xmyoot/rpi-cm5-edge-carrier/docs/img/layer_In1.png

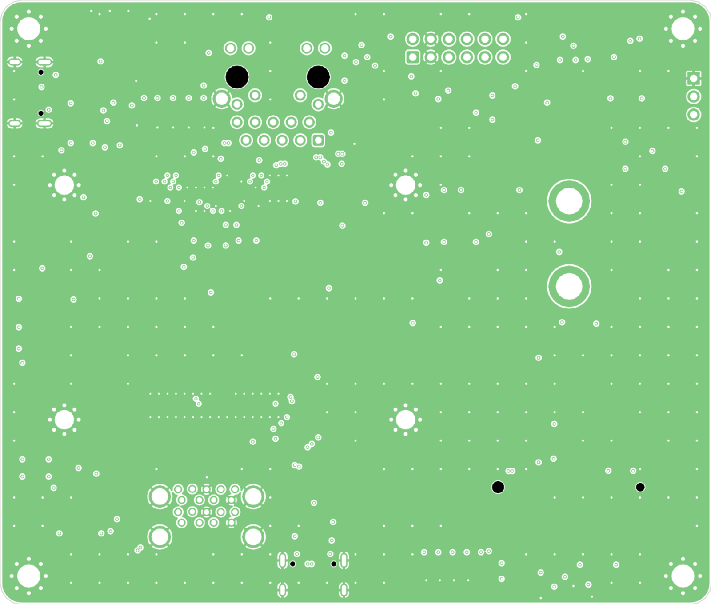
docs/img/layer_In1.png
