xmyoot/rpi-cm5-edge-carrier/docs/img/layer_In2.png

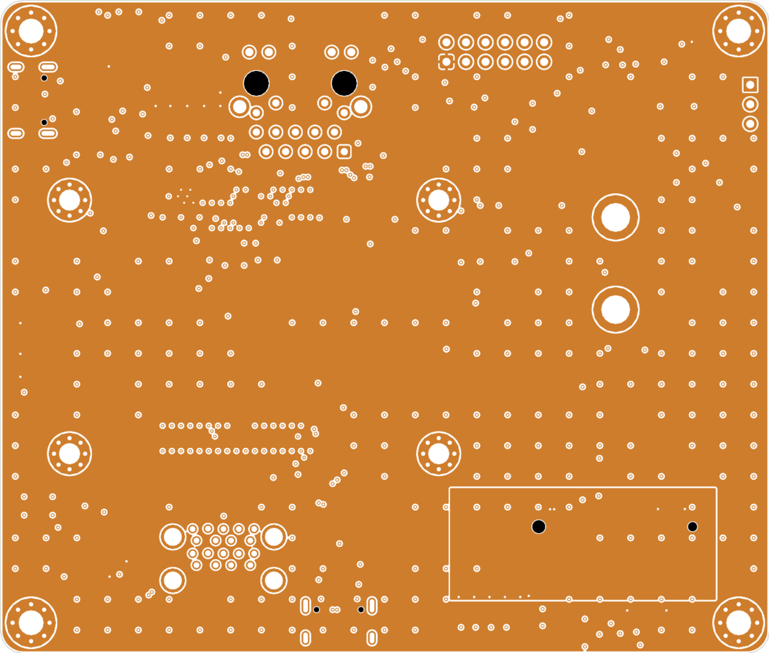
docs/img/layer_In2.png
