xmyoot/rpi-cm5-edge-carrier/docs/img/render_bottom.png

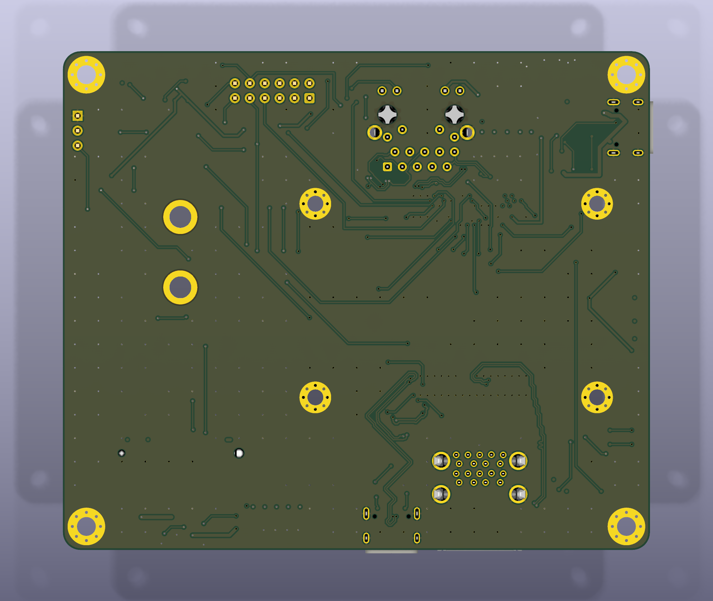
docs/img/render_bottom.png
