xmyoot/rpi-cm5-edge-carrier/docs/img/schematic-3.png

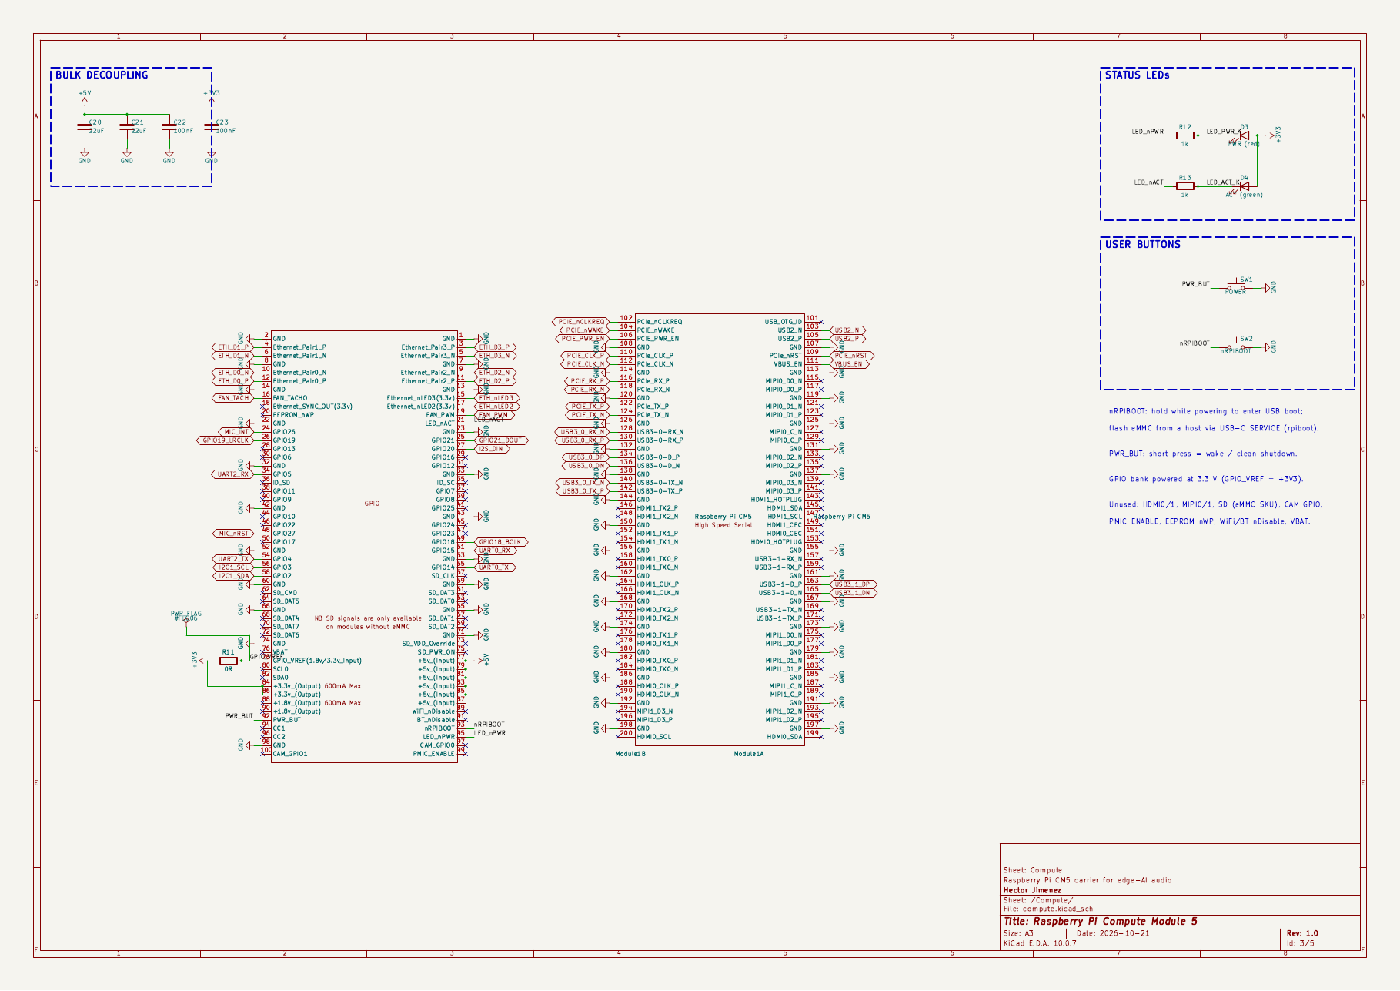
docs/img/schematic-3.png
