xmyoot/rpi-cm5-edge-carrier/docs/img/schematic-5.png

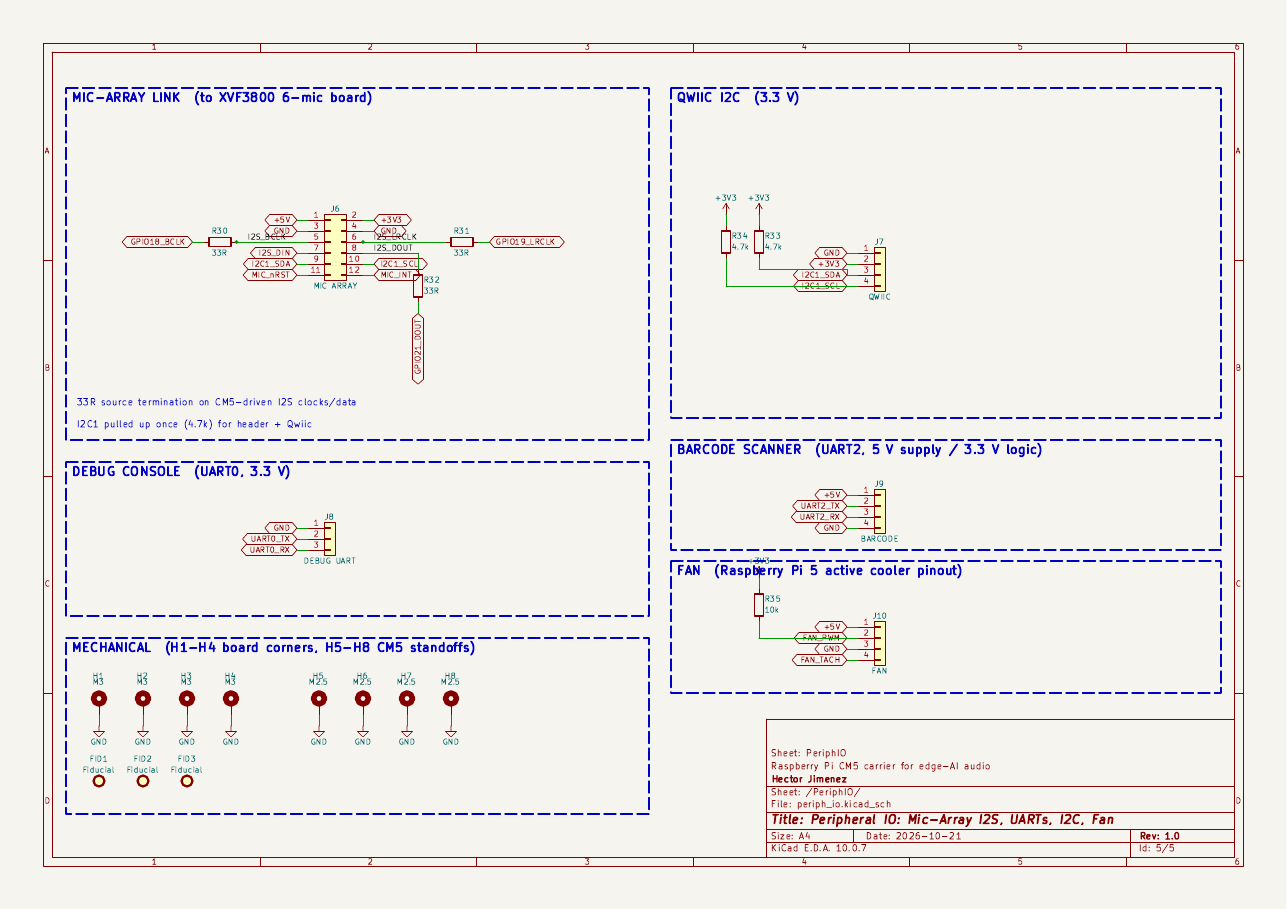
docs/img/schematic-5.png
