xmyoot/rpi-cm5-edge-carrier/fab/CM5_Edge_Carrier_BOM_JLC.csv

Comment | Designator | Footprint | Quantity | Manufacturer Part | JLCPCB Part #
22uF | C1,C2,C4 | C_1206_3216Metric | 3 |  | C12891
1uF | C3 | C_0402_1005Metric | 1 |  | C52923
100nF | C5,C6,C11,C17,C22,C23,C30,C34,C35 | C_0402_1005Metric | 9 |  | C1525
22uF | C7,C8,C9,C10,C20,C21,C32,C33 | C_0805_2012Metric | 8 |  | C45783
10uF | C12,C14,C15,C16,C31 | C_0805_2012Metric | 5 |  | C15850
4.7nF | C13 | C_0402_1005Metric | 1 |  | C1538
SMAJ15A | D1 | D_SMA | 1 | Littelfuse SMAJ15A
PD_OK | D2 | LED_0603_1608Metric | 1 |  | C72043
PWR (red) | D3 | LED_0603_1608Metric | 1 |  | C2286
ACT (green) | D4 | LED_0603_1608Metric | 1 |  | C72043
SSD (green) | D5 | LED_0603_1608Metric | 1 |  | C72043
USB-C PD IN | J1 | USB_C_Receptacle_GCT_USB4105-xx-A_16P_TopMnt_Horizontal | 1 | GCT USB4105-GF-A | C3020560
M.2 M-Key (NVMe 2230/2242) | J2 | M.2_M_Key_2242 | 1 | MTCONN MTSSD03-67MSW337 (H=3.2 mm)
USB 3.0 A x2 (stacked) | J3 | MTCONN_UBAF30-D2011 | 1 | MTCONN UBAF30-D2011
RJ45 MagJack 1000BASE-T | J4 | TRJG0926HENL | 1 | Trxcom TRJG0926HENL
USB-C SERVICE | J5 | USB_C_Receptacle_GCT_USB4105-xx-A_16P_TopMnt_Horizontal | 1 | GCT USB4105-GF-A | C3020560
MIC ARRAY | J6 | IDC-Header_2x06_P2.54mm_Vertical | 1 | 2x6 2.54 mm shrouded box header
QWIIC | J7 | JST_SH_SM04B-SRSS-TB_1x04-1MP_P1.00mm_Horizontal | 1 | JST SM04B-SRSS-TB | C160404
DEBUG UART | J8 | PinHeader_1x03_P2.54mm_Vertical | 1
BARCODE | J9 | JST_SH_SM04B-SRSS-TB_1x04-1MP_P1.00mm_Horizontal | 1 | JST SM04B-SRSS-TB | C160404
FAN | J10 | JST_SH_SM04B-SRSS-TB_1x04-1MP_P1.00mm_Horizontal | 1 | JST SM04B-SRSS-TB | C160404
2.2uH | L1 | L_Sunlord_MWSA0603S | 1 | Sunlord MWSA0603S-2R2MT
2.2uH | L2 | L_Bourns_SRP5030T | 1 | Bourns SRP5030T-2R2M
Raspberry Pi CM5 | Module1 | RPi_CM5_DF40 | 1 | Raspberry Pi CM5 + 2x Hirose DF40C-100DS-0.4V(51) | C597931 (x2)
1k | R1,R12,R13,R20 | R_0402_1005Metric | 4 |  | C11702
24k | R2 | R_0402_1005Metric | 1
4.7k | R3,R33,R34 | R_0402_1005Metric | 3 |  | C25900
100k | R4,R8 | R_0402_1005Metric | 2 |  | C25741
15k | R5,R21 | R_0402_1005Metric | 2 |  | C25756
56k | R6 | R_0402_1005Metric | 1 |  | C25796
10k | R7,R9,R35 | R_0402_1005Metric | 3 |  | C25744
2.2k | R10 | R_0402_1005Metric | 1 |  | C25879
0R | R11 | R_0402_1005Metric | 1 |  | C17168
470R | R22,R23 | R_0402_1005Metric | 2 |  | C25117
5.1k | R24,R25 | R_0402_1005Metric | 2 |  | C25905
33R | R30,R31,R32 | R_0402_1005Metric | 3 |  | C25105
POWER | SW1 | SW_SPST_B3U-1000P | 1 | Omron B3U-1000P | C231329
nRPIBOOT | SW2 | SW_SPST_B3U-1000P | 1 | Omron B3U-1000P | C231329
CH224K | U1 | SSOP-10-1EP_3.9x4.9mm_P1mm_EP2.1x3.3mm | 1 | WCH CH224K | C970725
TPS565208 | U2 | SOT-23-6 | 1 | TI TPS565208DDCR
AP3441SHE-7B | U3 | DFN-8-1EP_2x2mm_P0.5mm_EP0.9x1.7mm | 1 | Diodes AP3441SHE-7B
AP22653W6 | U4 | SOT-23-6 | 1 | Diodes AP22653W6-7
TPD4EUSB30 | U8,U9 | USON-10_2.5x1.0mm_P0.5mm | 2 | TI TPD4EUSB30DQAR
USBLC6-2SC6 | U10 | SOT-23-6 | 1 | ST USBLC6-2SC6 | C7519
