xmyoot/rpi-cm5-edge-carrier/fab/CM5_Edge_Carrier.step

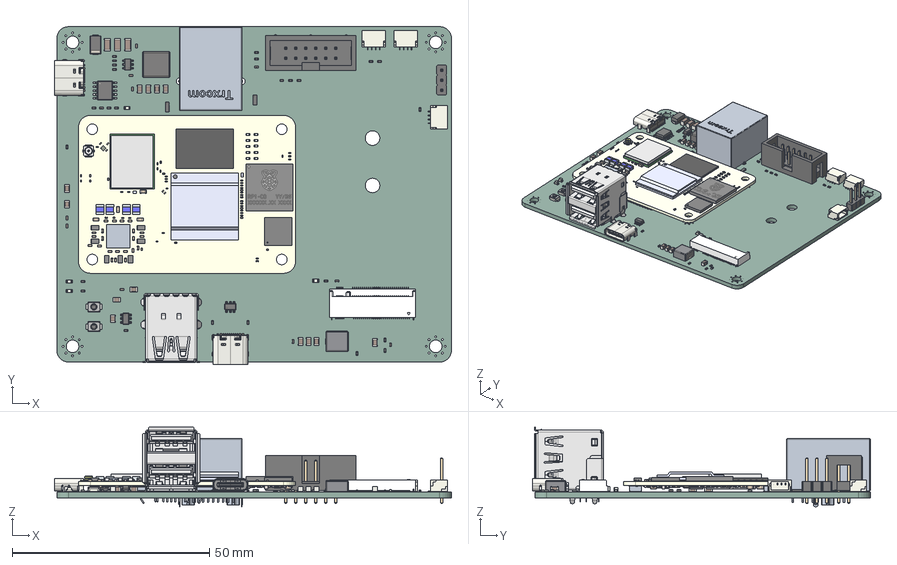
[picture p14: CAD file, 2026-10-21]
fab/CM5_Edge_Carrier.step
100.6 x 85.6 x 20.2 mm
PinHeader_1x03_P254mm_Vertical
R_0402_1005Metric x 25
LED_0603_1608Metric x 4
C_0402_1005Metric x 11
C_0805_2012Metric x 13
SW_SPST_B3U-1000P x 2
IDC_Header_2x06_P254mm_Vertical
SOT-23-6 x 3
SSOP-10-1EP_3.9x4.9mm_P1mm_EP2.1x3.3mm
MTSSD03-67MSW337(3D)
USON_10_25x10mm_Pitch05mm x 2
D_SMA
JST_SH_SM04B-SRSS-TB_1x04-1MP_P1.00mm_Horizontal x 3
TRJG0926HENL-S
USB_C_Receptacle_16P_TopMnt_Horizontal_GCT_USB4105-xx-A x 2
C_1206_3216Metric x 3
L_Bourns_SRP5030T
10164227-1001A1RLF x 2
200-ball_VFBGAold.step
CAP0201.step x 190
RES0201old.step x 71
CAP0402.step x 81
PMIC STEP.STEP
3D-SRP201208-R47MH-20230512 .step x 7
term2 x 4
term1 x 4
2712 v2 STEP.STEP
CAP0603.step x 10
RES0402.step x 10
SOT883B Mold body x 4
SOT883B4 LF x 4
User Library-SKY13351-378LF.step
ProjectY v3 STEP.STEP
(Unsaved)
PinIndicator
Pads x 2
Lid x 2
Plating
LDF
CPD
Pins
User Library-153BallWFBGA
10164228-1001A1RLF.stp x 2
ABM11-0022-T3.step x 2
DIELECTRIC_Model_1_Inst
USB30-DOUBLE-SHELL.stp.STEP
USB30-DOUBLE-HOUSING.stp.STEP
LONG-FEMALE-TERMINAL.stp.STEP
LONG-FEMALE-TERMINAL-1.stp.STEP
LONG-FEMALE-TERMINAL-2-3.stp.STEP x 2
SHORT-MALE-TERMINAL.stp.STEP x 5
SHORT-FEMALE-TERMINAL.stp.STEP x 2
USB30-MILDDLE-SHELL.stp.STEP
USB30-HOUSING-COVER.stp.STEP
5PLONG-2.stp.STEP x 4
LONG-MALE-TERMINAL.stp.STEP
SHORT-FEMALE-TERMINAL-2-3.stp.STEP x 2
a71ba5e0-8551-11ed-a139-00155d22e2d7_part
a71ba716-8551-11ed-a139-00155d22e2d7_part
a71ba78e-8551-11ed-a139-00155d22e2d7_part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
