xmyoot/rpi-cm5-edge-carrier/docs/CM5_Edge_Carrier_schematic.pdf

1 | 2 | 3 | 4 | 5 | 6 | 7 | 8

AB

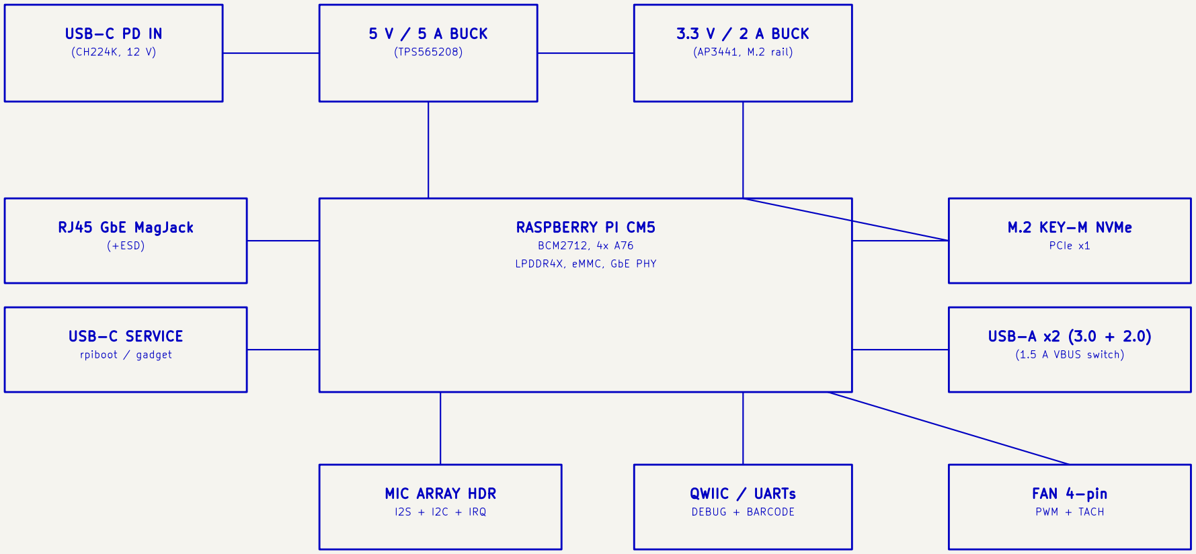
[picture p15: figure]
USB-C SERVICE; QWIIC / UARTs; DEBUG + BARCODE; FAN 4-pin; (1.5 A VBUS switch); USB-A x2 (3.0 + 2.0); USB-C PD IN; 5 V / 5 A BUCK; PCIe x1; (TPS565208); RASPBERRY PI CM5; LPDDR4X, eMMC, GbE PHY; M.2 KEY-M NVMe; RJ45 GbE MagJack; (+ESD); BCM2712, 4x A76; (AP3441, M.2 rail); MIC ARRAY HDR; I2S + I2C + IRQ; 3.3 V / 2 A BUCK; rpiboot / gadget; PWM + TACH

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
Size: A3 | Rev: 1.0 | F Date: 2026-10-21
KiCad E.D.A. 10.0.7 | Id: 1/5

## Title: CM5 Edge-Audio Carrier

File: CM5_Edge_Carrier.kicad_sch

Sheet: /

Hector Jimenez

Raspberry Pi CM5 carrier for edge-AI audio

Sheet: Root

PeriphIO

File: periph_io.kicad_sch

HighSpeed

File: highspeed.kicad_sch

Compute

File: compute.kicad_sch

Power File: power.kicad_sch

7. Boot: hold nRPIBOOT while plugging USB-C SERVICE into a host to flash eMMC with rpiboot.
6. Stackup: JLCPCB JLC04161H-7628, 1.6 mm, L1 SIG / L2 GND / L3 PWR (+5V, +3V3_M2) / L4 SIG.
5. ESD: TPD4EUSB30 on every GbE pair, USBLC6-2 on service USB-C, SMAJ15A on VBUS (USB-A per RPi reference).

## Hierarchical sheets

Power: USB-C PD Input, 5 V and 3.3 V Bucks

Raspberry Pi Compute Module 5

3. PCIe x1 (Gen2 default, Gen3 via dtparam=pciex1_gen=3): 85 ohm diff, length-matched P/N within 0.1 mm. | High-Speed IO: PCIe NVMe, USB 3.0, GbE, USB-C Service

Peripheral IO: Mic-Array I2S, UARTs, I2C, Fan

1. Input: USB-C PD sink requests 12 V / 3 A (36 W). Buck EN divider (100k/15k) holds the 5 V rail off below ~9 V,

# CM5 Edge-Audio Carrier - System Block Diagram

4. USB 3.0 SuperSpeed: 90 ohm diff; GbE MDI: 100 ohm diff; all on L1 referenced to solid GND on L2.

TX AC-coupling capacitors are on the CM5; RX caps are on the NVMe module.

2. CM5 CC1/CC2 left open: set usb_max_current_enable=1 in config.txt to allow 1.6 A on the USB-A ports.

so a non-PD 5 V source can never back-feed the CM5 at low voltage.

## DESIGN NOTES

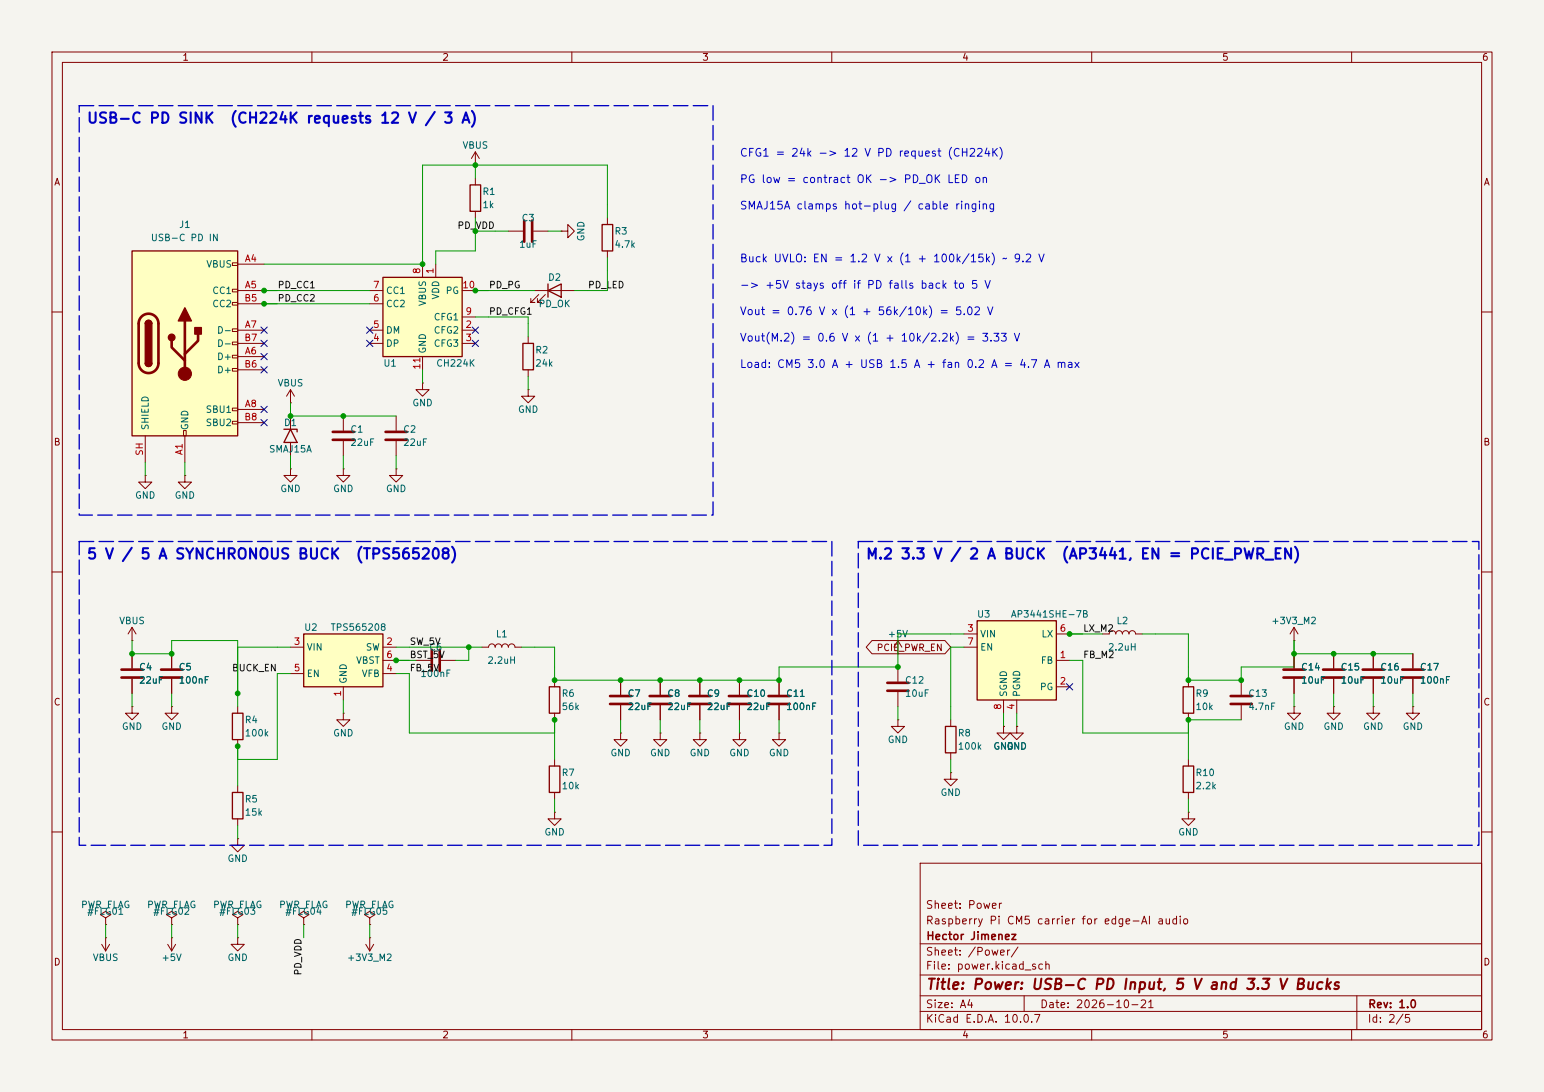
[picture p16: page 2]

USB-C PD SINK (CH224K requests 12 V / 3 A)

PG low = contract OK -> PD_OK LED on 5 V / 5 A SYNCHRONOUS BUCK (TPS565208)

SMAJ15A clamps hot-plug / cable ringing

Vout = 0.76 V x (1 + 56k/10k) = 5.02 V -> +5V stays off if PD falls back to 5 V

Vout(M.2) = 0.6 V x (1 + 10k/2.2k) = 3.33 V
Load: CM5 3.0 A + USB 1.5 A + fan 0.2 A = 4.7 A max M.2 3.3 V / 2 A BUCK (AP3441, EN = PCIE_PWR_EN)

Raspberry Pi CM5 carrier for edge-AI audio
Hector Jimenez
Sheet: /Power/
File: power.kicad_sch
Title: Power: USB-C PD Input, 5 V and 3.3 V Bucks

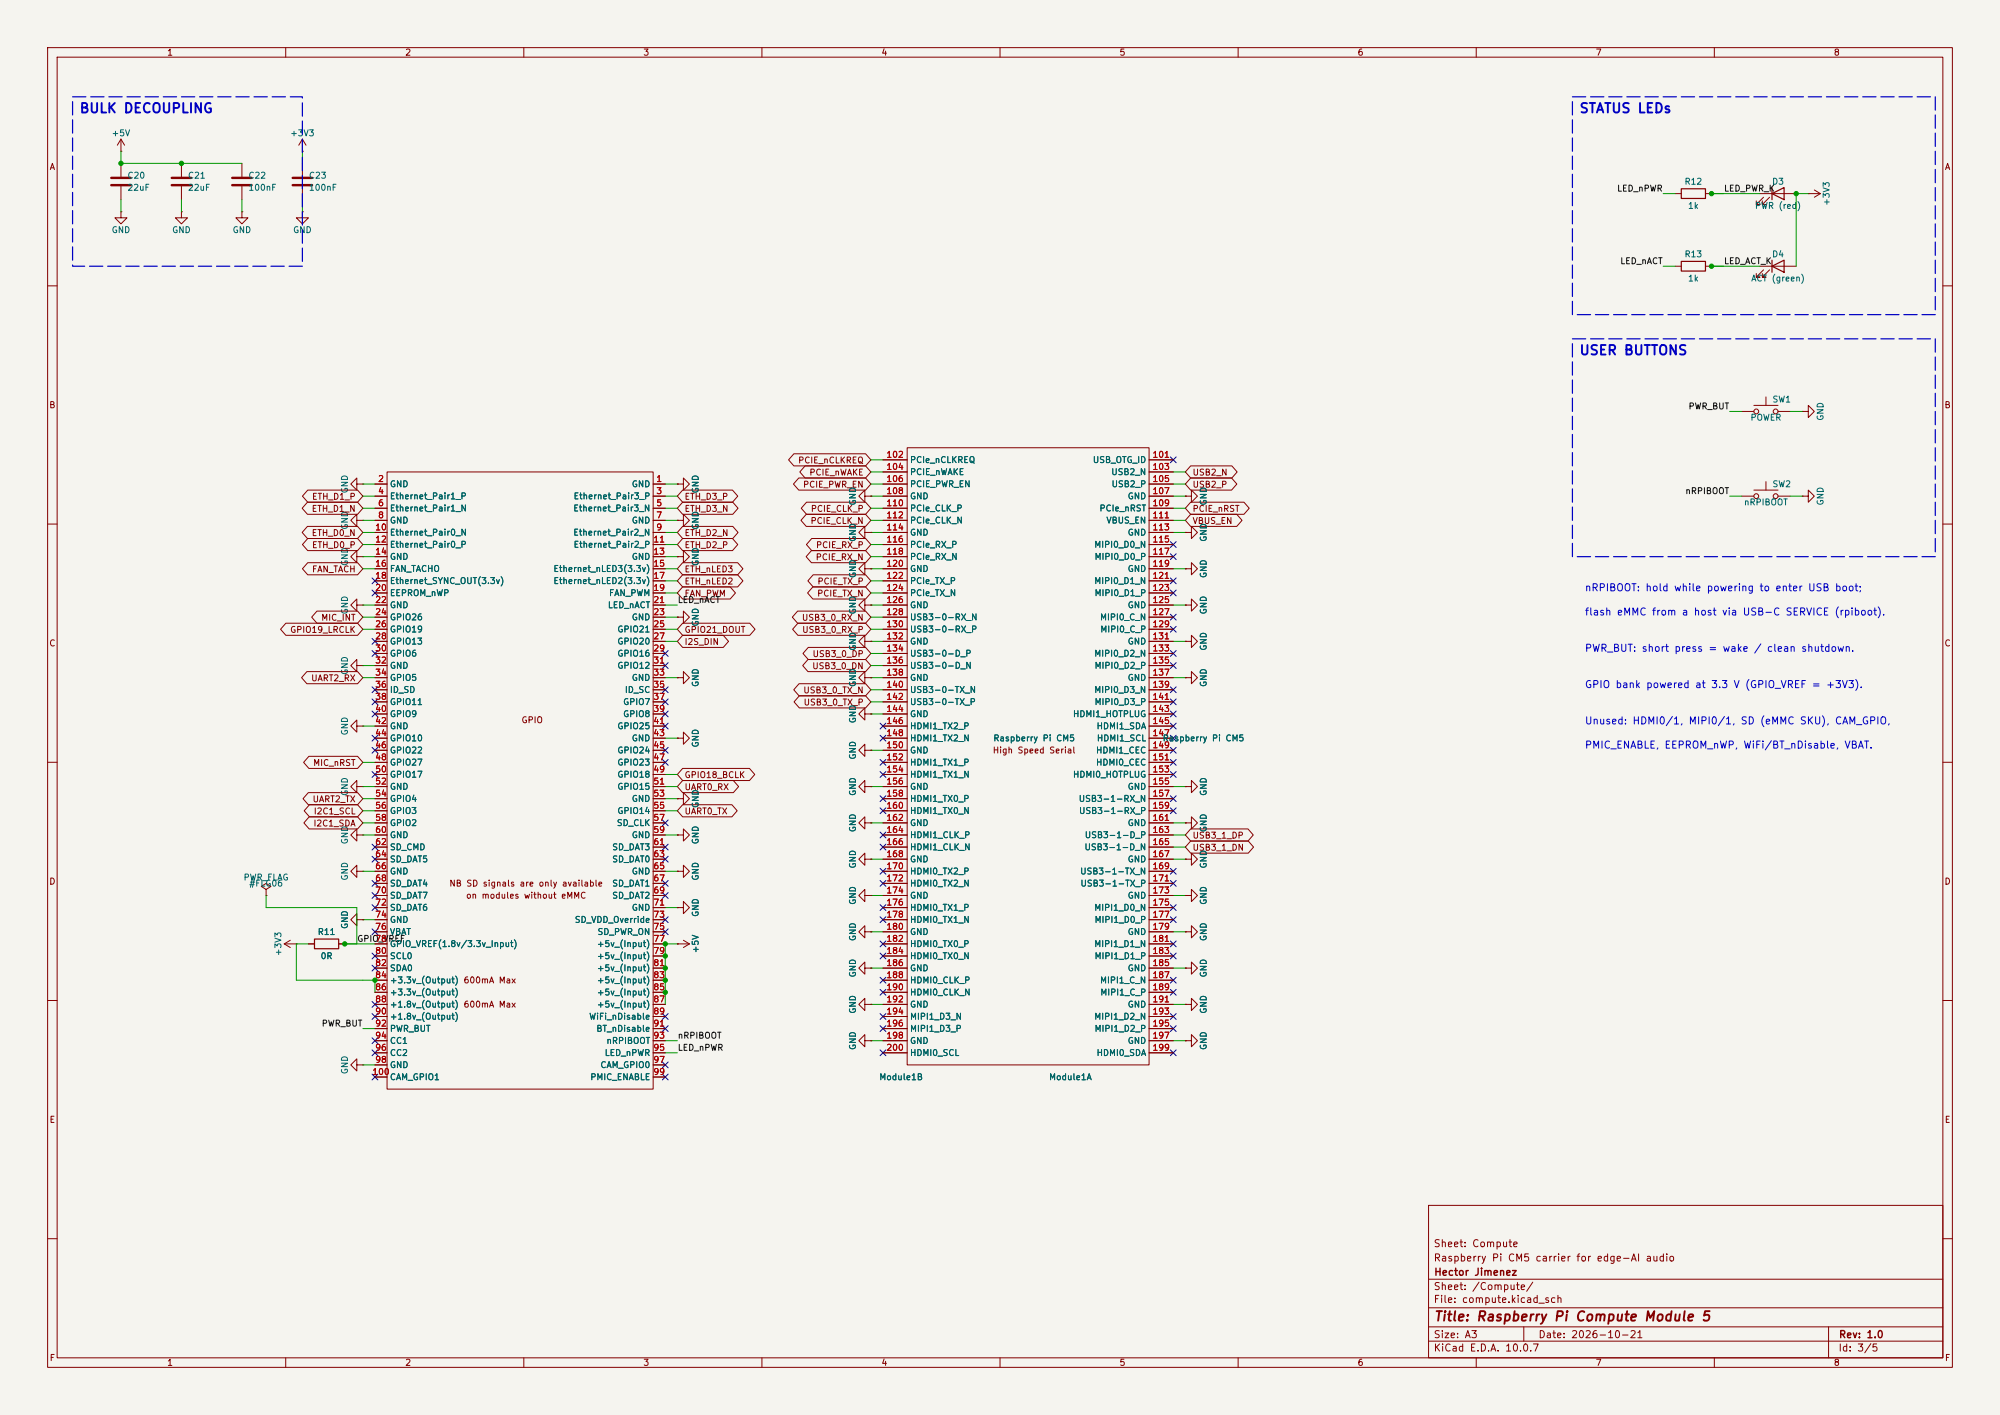
[picture p17: page 3]

nRPIBOOT: hold while powering to enter USB boot;

Sheet: Compute GND GND GND

flash eMMC from a host via USB-C SERVICE (rpiboot).

PWR_BUT: short press = wake / clean shutdown.

GPIO bank powered at 3.3 V (GPIO_VREF = +3V3).

Unused: HDMI0/1, MIPI0/1, SD (eMMC SKU), CAM_GPIO,

600mA Max 600mA Max NB SD signals are only available on modules without eMMC

Raspberry Pi CM5 carrier for edge-AI audio
Hector Jimenez
Sheet: /Compute/
File: compute.kicad_sch
Title: Raspberry Pi Compute Module 5

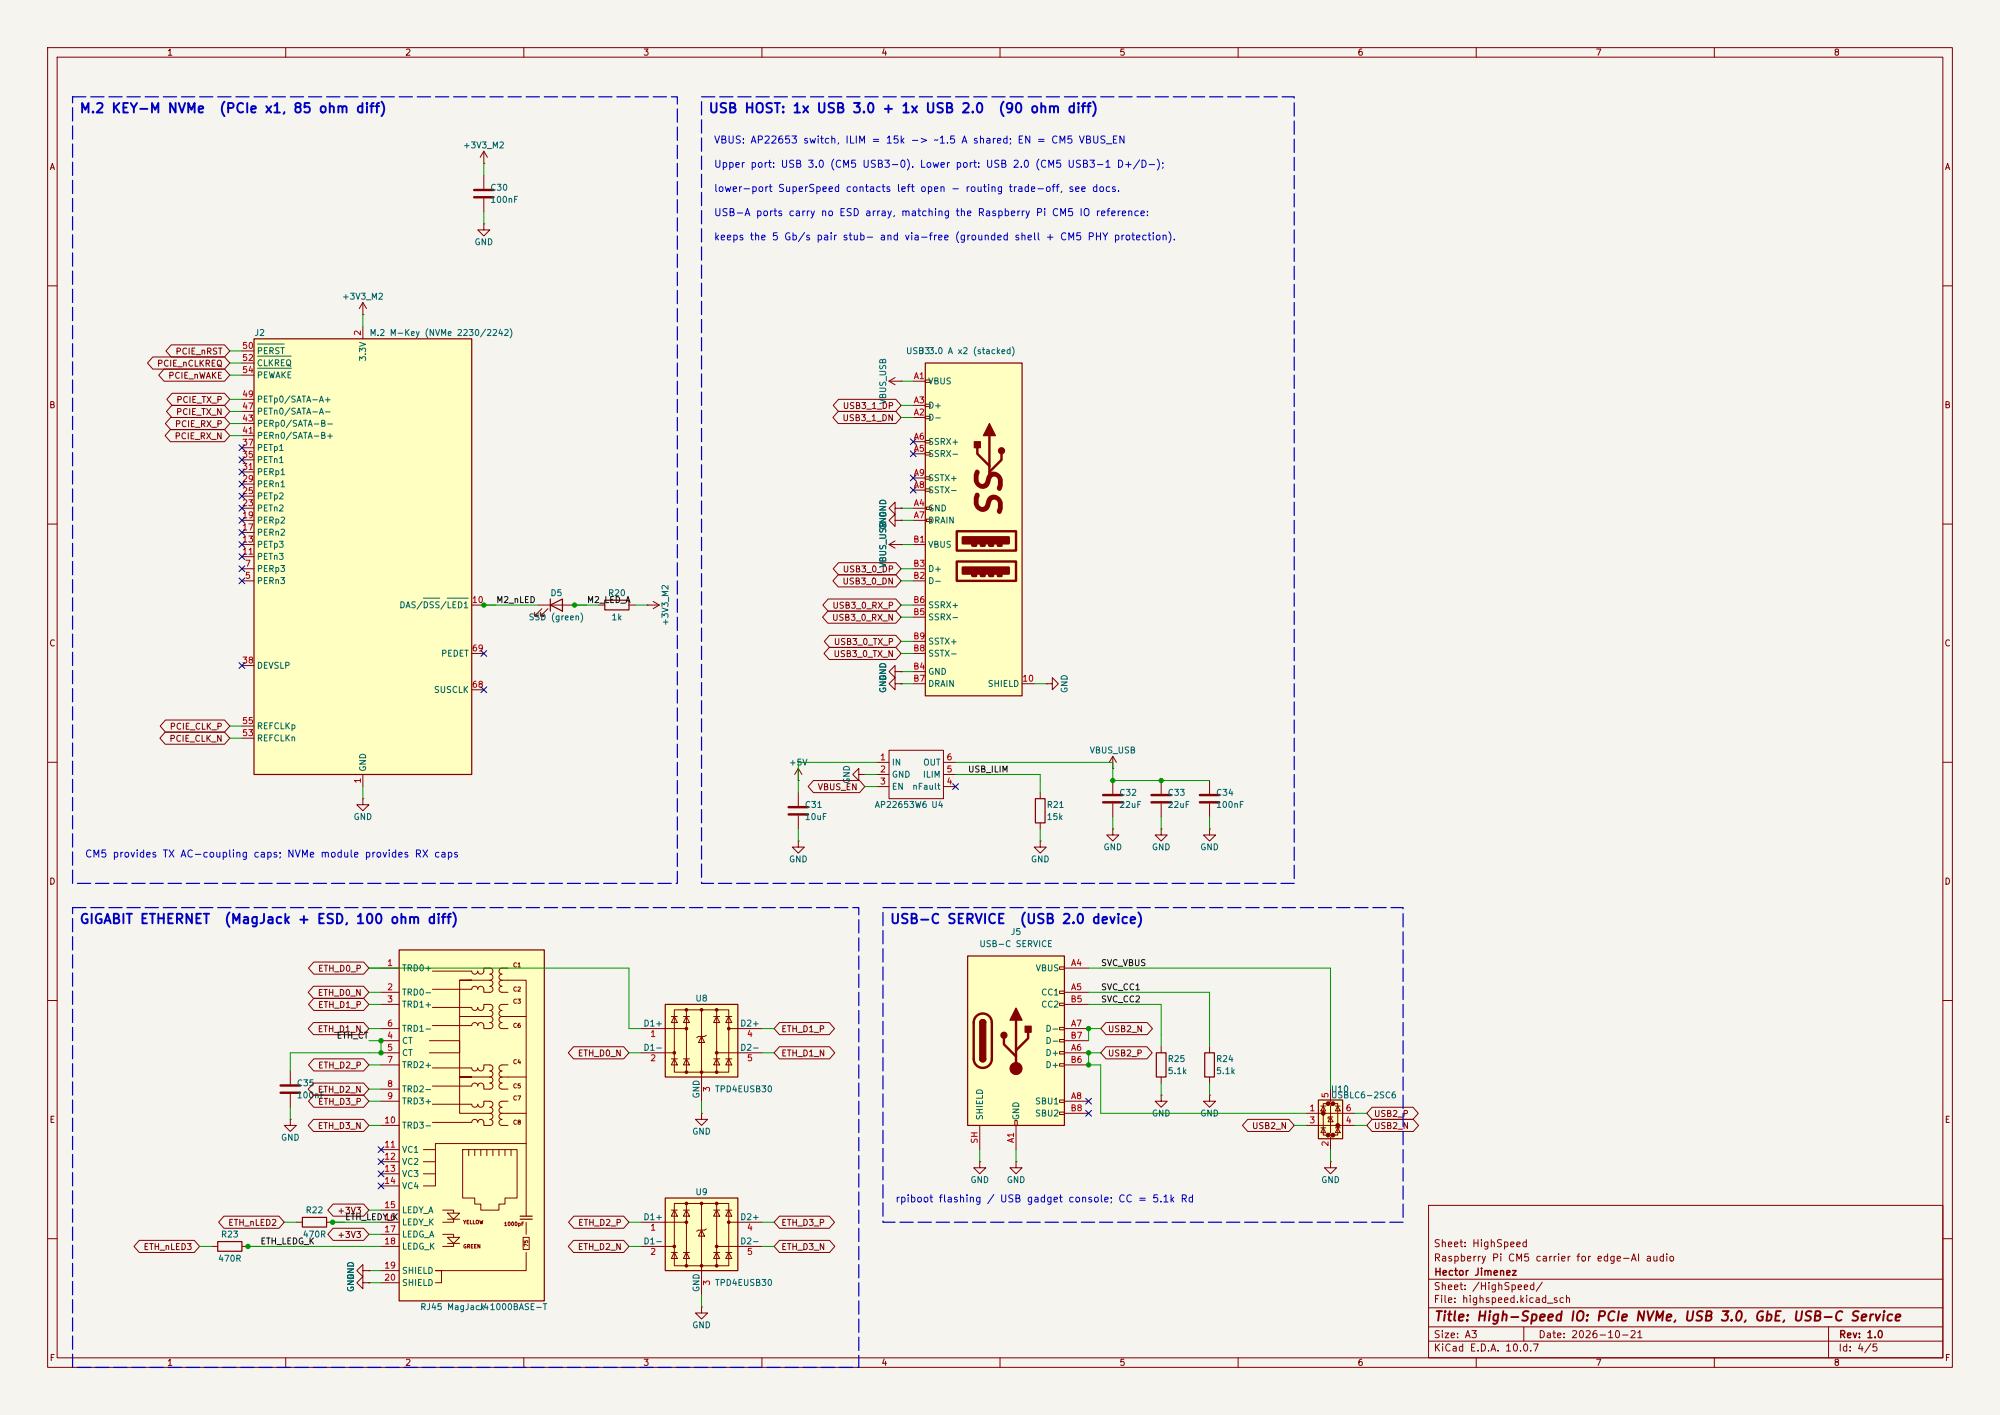
[picture p18: page 4]

M.2 KEY-M NVMe (PCIe x1, 85 ohm diff)

USB HOST: 1x USB 3.0 + 1x USB 2.0 (90 ohm diff)

VBUS: AP22653 switch, ILIM = 15k -> ~1.5 A shared; EN = CM5 VBUS_EN

Upper port: USB 3.0 (CM5 USB3-0). Lower port: USB 2.0 (CM5 USB3-1 D+/D-);

lower-port SuperSpeed contacts left open - routing trade-off, see docs.

keeps the 5 Gb/s pair stub- and via-free (grounded shell + CM5 PHY protection).

1 3.3V 2 PERn3 5 PERp3 7 DAS/DSS/LED1 10 PETn3 11 PETp3 13 PERn2 17 PERp2 19 PETn2 23 PETp2 25 PERn1 29 PERp1 31 PETn1 35 PETp1 37 DEVSLP 38 PERn0/SATA-B+ 41 PERp0/SATA-B- 43 PETn0/SATA-A- 47 PETp0/SATA-A+ 49 PERST 50 CLKREQ 52 REFCLKn 53 PEWAKE 54 REFCLKp 55

USB-C SERVICE (USB 2.0 device) GND VBUS_USB GND GND

CM5 provides TX AC-coupling caps; NVMe module provides RX caps

GIGABIT ETHERNET (MagJack + ESD, 100 ohm diff)

rpiboot flashing / USB gadget console; CC = 5.1k Rd

Sheet: HighSpeed
Raspberry Pi CM5 carrier for edge-AI audio
Hector Jimenez
Sheet: /HighSpeed/
File: highspeed.kicad_sch
Title: High-Speed IO: PCIe NVMe, USB 3.0, GbE, USB-C Service

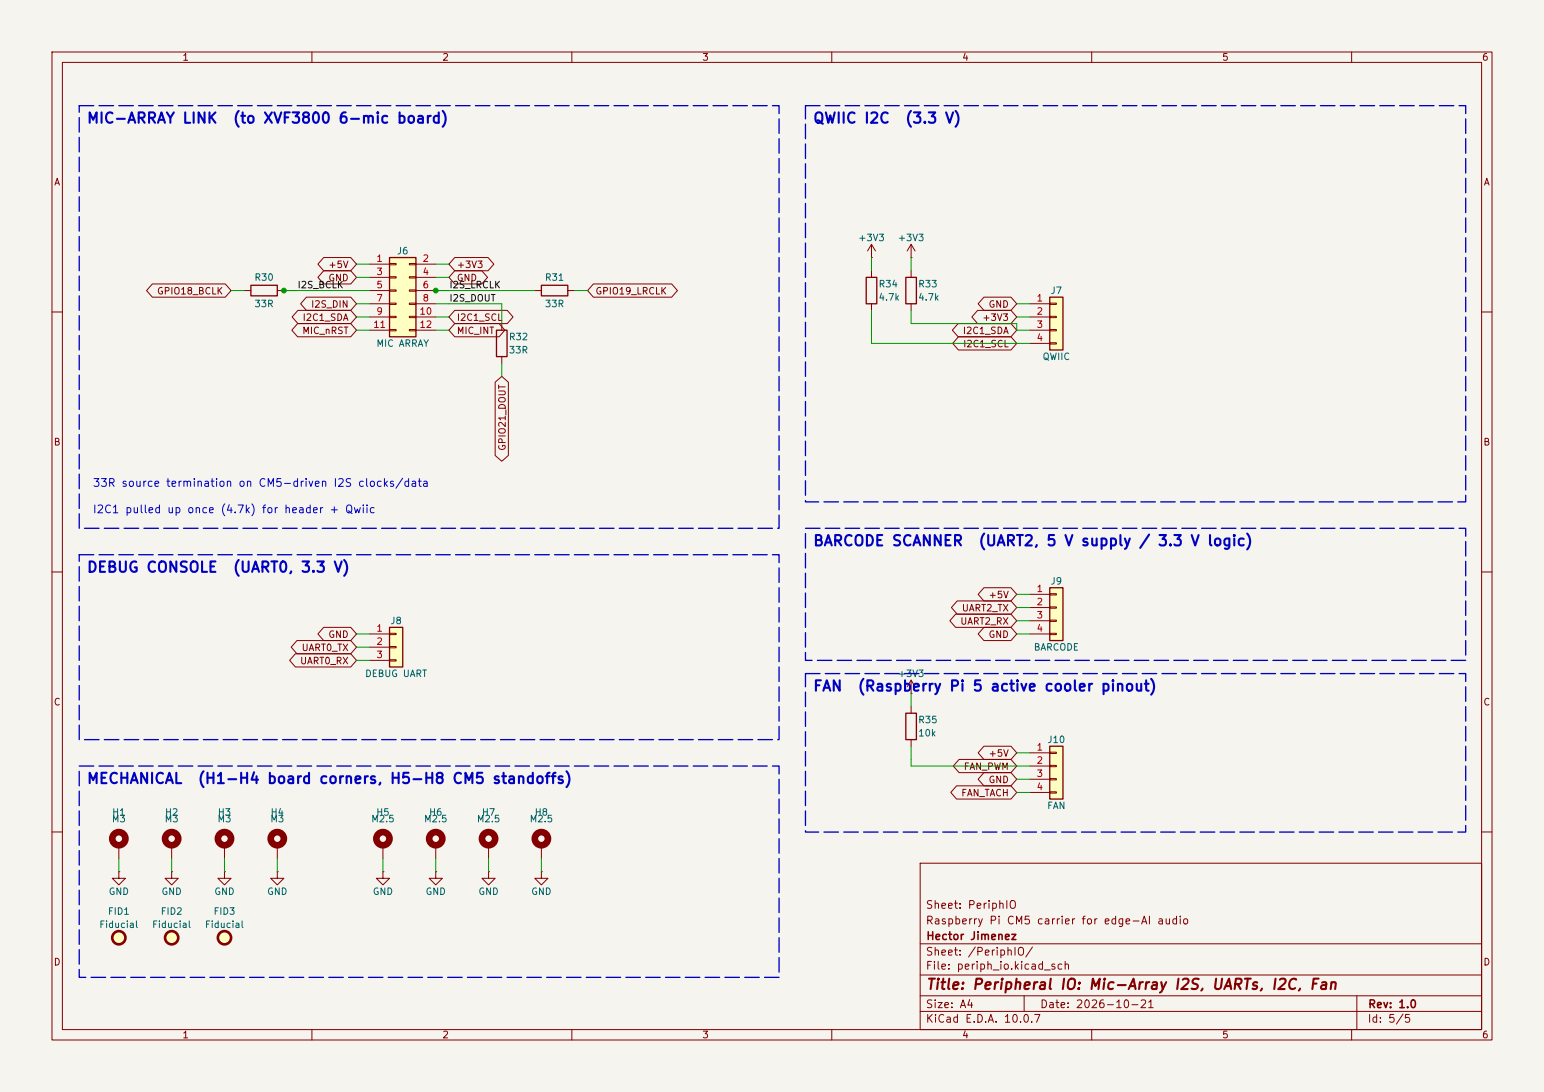
[picture p19: page 5]

MIC-ARRAY LINK (to XVF3800 6-mic board)

33R source termination on CM5-driven I2S clocks/data

I2C1 pulled up once (4.7k) for header + Qwiic

BARCODE SCANNER (UART2, 5 V supply / 3.3 V logic)

MECHANICAL (H1-H4 board corners, H5-H8 CM5 standoffs)

Sheet: PeriphIO
Raspberry Pi CM5 carrier for edge-AI audio
Hector Jimenez
Sheet: /PeriphIO/
File: periph_io.kicad_sch
Title: Peripheral IO: Mic-Array I2S, UARTs, I2C, Fan
