xmyoot/rpi-cm5-edge-carrier/fab/CM5_Edge_Carrier_top_assembly.pdf

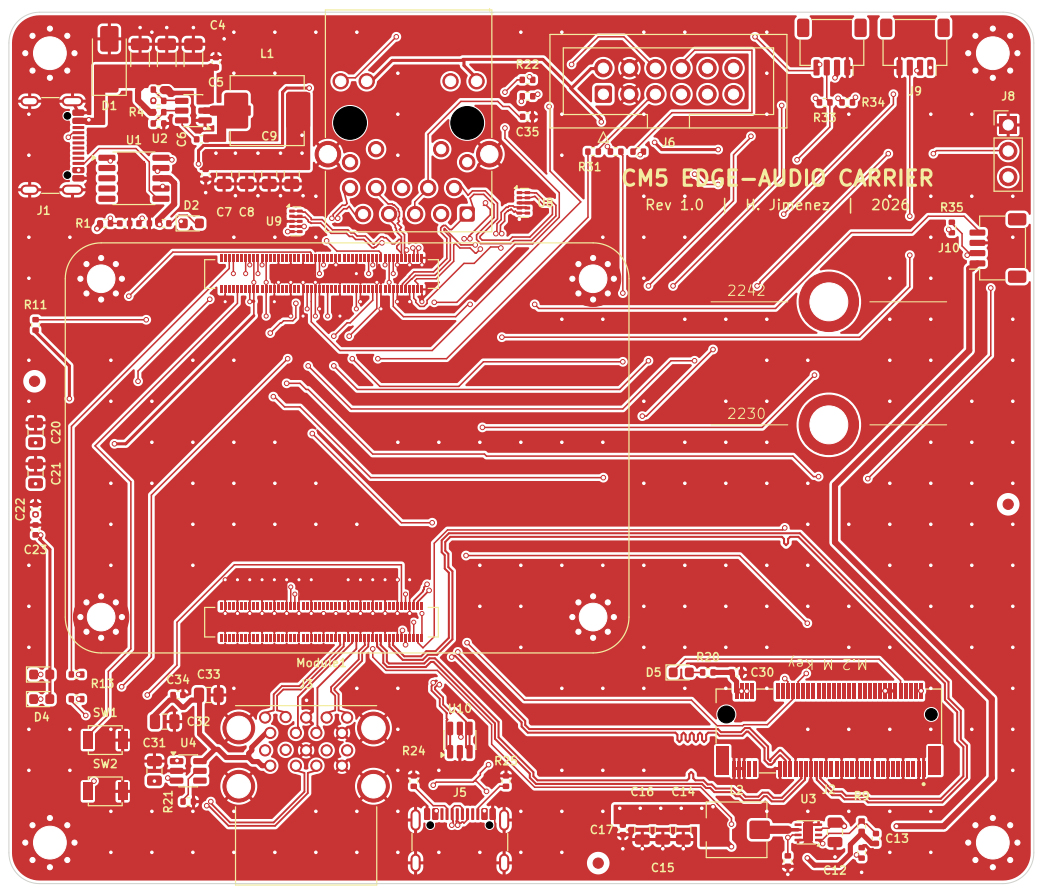
[picture p20: page 1]

Rev 1.0 | H. Jimenez | 2026 CM5 EDGE-AUDIO CARRIER
