xmyoot/rpi-cm5-edge-carrier/hardware/CM5_Edge_Carrier.kicad_pcb

## KiCad design hardware/CM5_Edge_Carrier.kicad_pcb (2026-10-21)

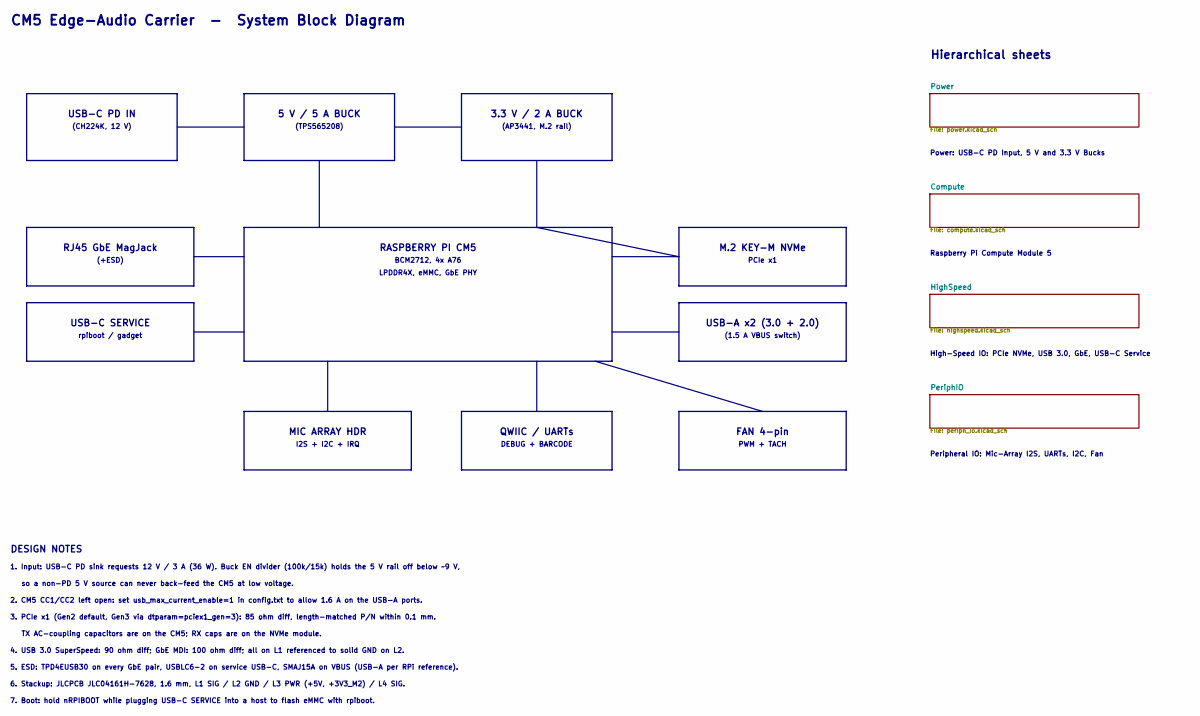
[picture p21: schematic CM5_Edge_Carrier.kicad_sch, CM5 Edge-Audio Carrier]

Notes on the sheet:
USB-C PD IN
(CH224K, 12 V)
5 V / 5 A BUCK
(TPS565208)
3.3 V / 2 A BUCK
(AP3441, M.2 rail)
RASPBERRY PI CM5
BCM2712, 4x A76
LPDDR4X, eMMC, GbE PHY
M.2 KEY-M NVMe
PCIe x1
USB-A x2 (3.0 + 2.0)
(1.5 A VBUS switch)
RJ45 GbE MagJack
(+ESD)
USB-C SERVICE
rpiboot / gadget
MIC ARRAY HDR
I2S + I2C + IRQ
QWIIC / UARTs
DEBUG + BARCODE
FAN 4-pin
PWM + TACH
CM5 Edge-Audio Carrier - System Block Diagram
DESIGN NOTES
1. Input: USB-C PD sink requests 12 V / 3 A (36 W). Buck EN divider (100k/15k) holds the 5 V rail off below ~9 V,
so a non-PD 5 V source can never back-feed the CM5 at low voltage.
2. CM5 CC1/CC2 left open: set usb_max_current_enable=1 in config.txt to allow 1.6 A on the USB-A ports.
3. PCIe x1 (Gen2 default, Gen3 via dtparam=pciex1_gen=3): 85 ohm diff, length-matched P/N within 0.1 mm.
TX AC-coupling capacitors are on the CM5; RX caps are on the NVMe module.
4. USB 3.0 SuperSpeed: 90 ohm diff; GbE MDI: 100 ohm diff; all on L1 referenced to solid GND on L2.
5. ESD: TPD4EUSB30 on every GbE pair, USBLC6-2 on service USB-C, SMAJ15A on VBUS (USB-A per RPi reference).
6. Stackup: JLCPCB JLC04161H-7628, 1.6 mm, L1 SIG / L2 GND / L3 PWR (+5V, +3V3_M2) / L4 SIG.
7. Boot: hold nRPIBOOT while plugging USB-C SERVICE into a host to flash eMMC with rpiboot.
Hierarchical sheets
Power: USB-C PD Input, 5 V and 3.3 V Bucks
Raspberry Pi Compute Module 5
High-Speed IO: PCIe NVMe, USB 3.0, GbE, USB-C Service
Peripheral IO: Mic-Array I2S, UARTs, I2C, Fan

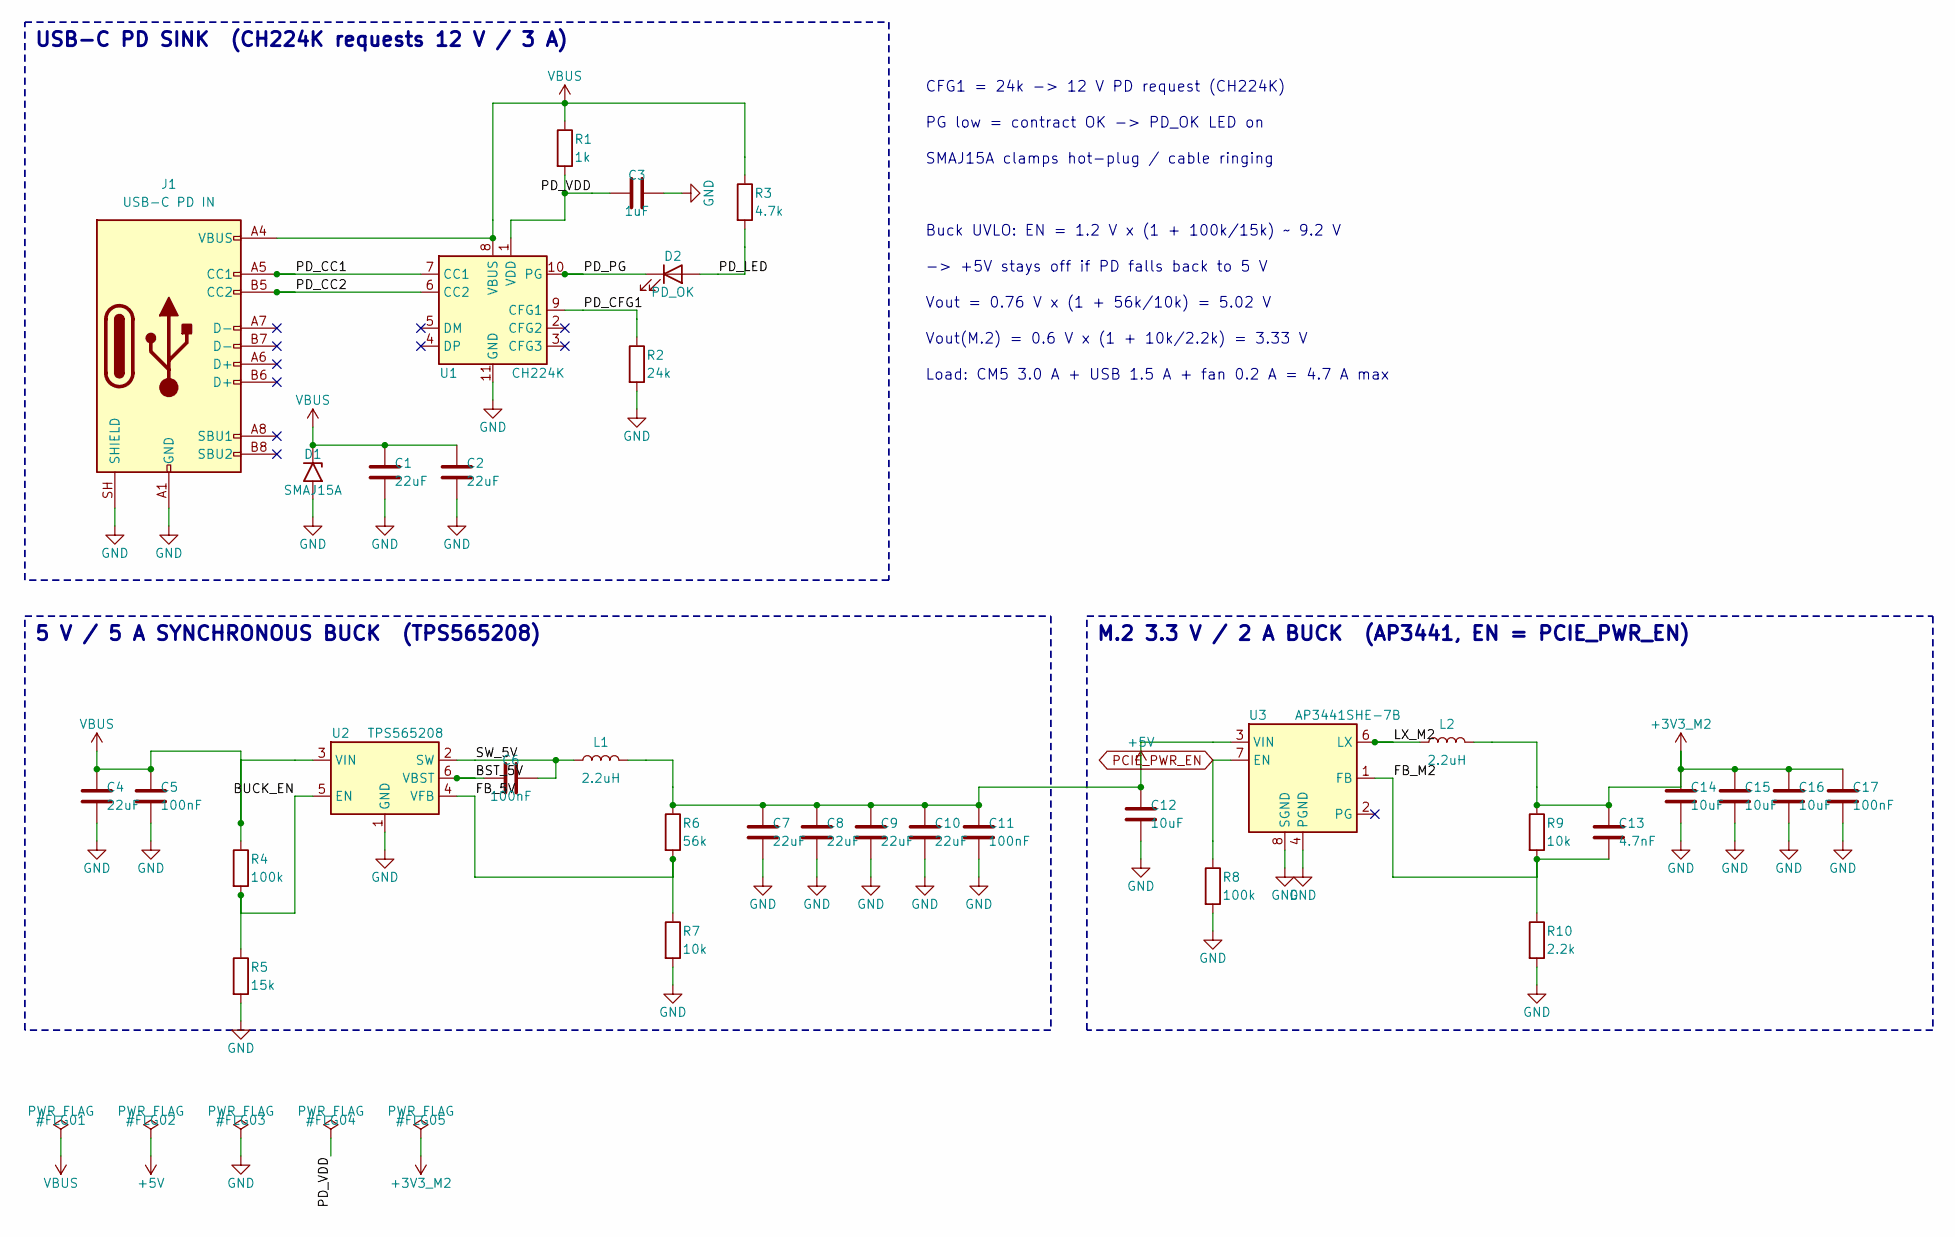
[picture p22: schematic power.kicad_sch, Power: USB-C PD Input, 5 V and 3.3 V Bucks]

Parts:
C1, C2, C4: 22uF; C_1206_3216Metric; Voltage 25V; LCSC C12891
C3: 1uF; C_0402_1005Metric; Voltage 16V; LCSC C52923
C5, C6, C11, C17: 100nF; C_0402_1005Metric; Voltage 16V; LCSC C1525
C7, C8, C9, C10: 22uF; C_0805_2012Metric; Voltage 10V; LCSC C45783
C12, C14, C15, C16: 10uF; C_0805_2012Metric; Voltage 10V; LCSC C15850
C13: 4.7nF; C_0402_1005Metric; Voltage 16V; LCSC C1538
D1: SMAJ15A; D_SMA; MPN Littelfuse SMAJ15A
D2: PD_OK; LED_0603_1608Metric; LCSC C72043
J1: USB-C PD IN; USB_C_Receptacle_GCT_USB4105-xx-A_16P_TopMnt_Horizontal; MPN GCT USB4105-GF-A; LCSC C3020560
L1: 2.2uH; L_Sunlord_MWSA0603S; Rating 2.2uH 10A; MPN Sunlord MWSA0603S-2R2MT
L2: 2.2uH; L_Bourns_SRP5030T; Rating 2.2uH 6.5A; MPN Bourns SRP5030T-2R2M
R1: 1k; R_0402_1005Metric; Tolerance 1%; LCSC C11702
R2: 24k; R_0402_1005Metric; Tolerance 1%
R3: 4.7k; R_0402_1005Metric; Tolerance 1%; LCSC C25900
R4, R8: 100k; R_0402_1005Metric; Tolerance 1%; LCSC C25741
R5: 15k; R_0402_1005Metric; Tolerance 1%; LCSC C25756
R6: 56k; R_0402_1005Metric; Tolerance 1%; LCSC C25796
R7, R9: 10k; R_0402_1005Metric; Tolerance 1%; LCSC C25744
R10: 2.2k; R_0402_1005Metric; Tolerance 1%; LCSC C25879
U1: CH224K; SSOP-10-1EP_3.9x4.9mm_P1mm_EP2.1x3.3mm; MPN WCH CH224K; LCSC C970725
U2: TPS565208; SOT-23-6; MPN TI TPS565208DDCR
U3: AP3441SHE-7B; DFN-8-1EP_2x2mm_P0.5mm_EP0.9x1.7mm; MPN Diodes AP3441SHE-7B

Connections:
+3V3_M2: C13.1, C14.1, C15.1, C16.1, C17.1, L2.2, R9.1; also elsewhere on the board
+5V: C7.1, C8.1, C9.1, C10.1, C11.1, C12.1, L1.2, R6.1, U3.3 (VIN); also elsewhere on the board
/Power/BST_5V: C6.1, U2.6 (VBST)
/Power/BUCK_EN: R4.2, R5.1, U2.5 (EN)
/Power/FB_5V: R6.2, R7.1, U2.4 (VFB)
/Power/FB_M2: C13.2, R9.2, R10.1, U3.1 (FB)
/Power/LX_M2: L2.1, U3.6 (LX)
/Power/PD_CC1: J1.A5 (CC1), U1.7 (CC1)
/Power/PD_CC2: J1.B5 (CC2), U1.6 (CC2)
/Power/PD_CFG1: R2.1, U1.9 (CFG1)
/Power/PD_LED: D2.2 (A), R3.2
/Power/PD_PG: D2.1 (K), U1.10 (PG)
/Power/PD_VDD: C3.1, R1.2, U1.1 (VDD)
/Power/SW_5V: C6.2, L1.1, U2.2 (SW)
GND: C1.2, C2.2, C3.2, C4.2, C5.2, C7.2, C8.2, C9.2, C10.2, C11.2, C12.2, C14.2, C15.2, C16.2, C17.2, D1.2 (A2), J1.A1 (GND), J1.A12 (GND), J1.B1 (GND), J1.B12 (GND), J1.SH (SHIELD), R2.2, R5.2, R7.2, R8.2, R10.2, U1.11 (GND), U2.1 (GND), U3.4 (PGND), U3.8 (SGND), U3.9 (SGND); also elsewhere on the board
PCIE_PWR_EN: R8.1, U3.7 (EN); also elsewhere on the board
VBUS: C1.1, C2.1, C4.1, C5.1, D1.1 (A1), J1.A4 (VBUS), J1.A9 (VBUS), J1.B4 (VBUS), J1.B9 (VBUS), R1.1, R3.1, R4.1, U1.8 (VBUS), U2.3 (VIN)

Notes on the sheet:
USB-C PD SINK (CH224K requests 12 V / 3 A)
5 V / 5 A SYNCHRONOUS BUCK (TPS565208)
M.2 3.3 V / 2 A BUCK (AP3441, EN = PCIE_PWR_EN)
CFG1 = 24k -> 12 V PD request (CH224K)
PG low = contract OK -> PD_OK LED on
SMAJ15A clamps hot-plug / cable ringing
Buck UVLO: EN = 1.2 V x (1 + 100k/15k) ~ 9.2 V
-> +5V stays off if PD falls back to 5 V
Vout = 0.76 V x (1 + 56k/10k) = 5.02 V
Vout(M.2) = 0.6 V x (1 + 10k/2.2k) = 3.33 V
Load: CM5 3.0 A + USB 1.5 A + fan 0.2 A = 4.7 A max

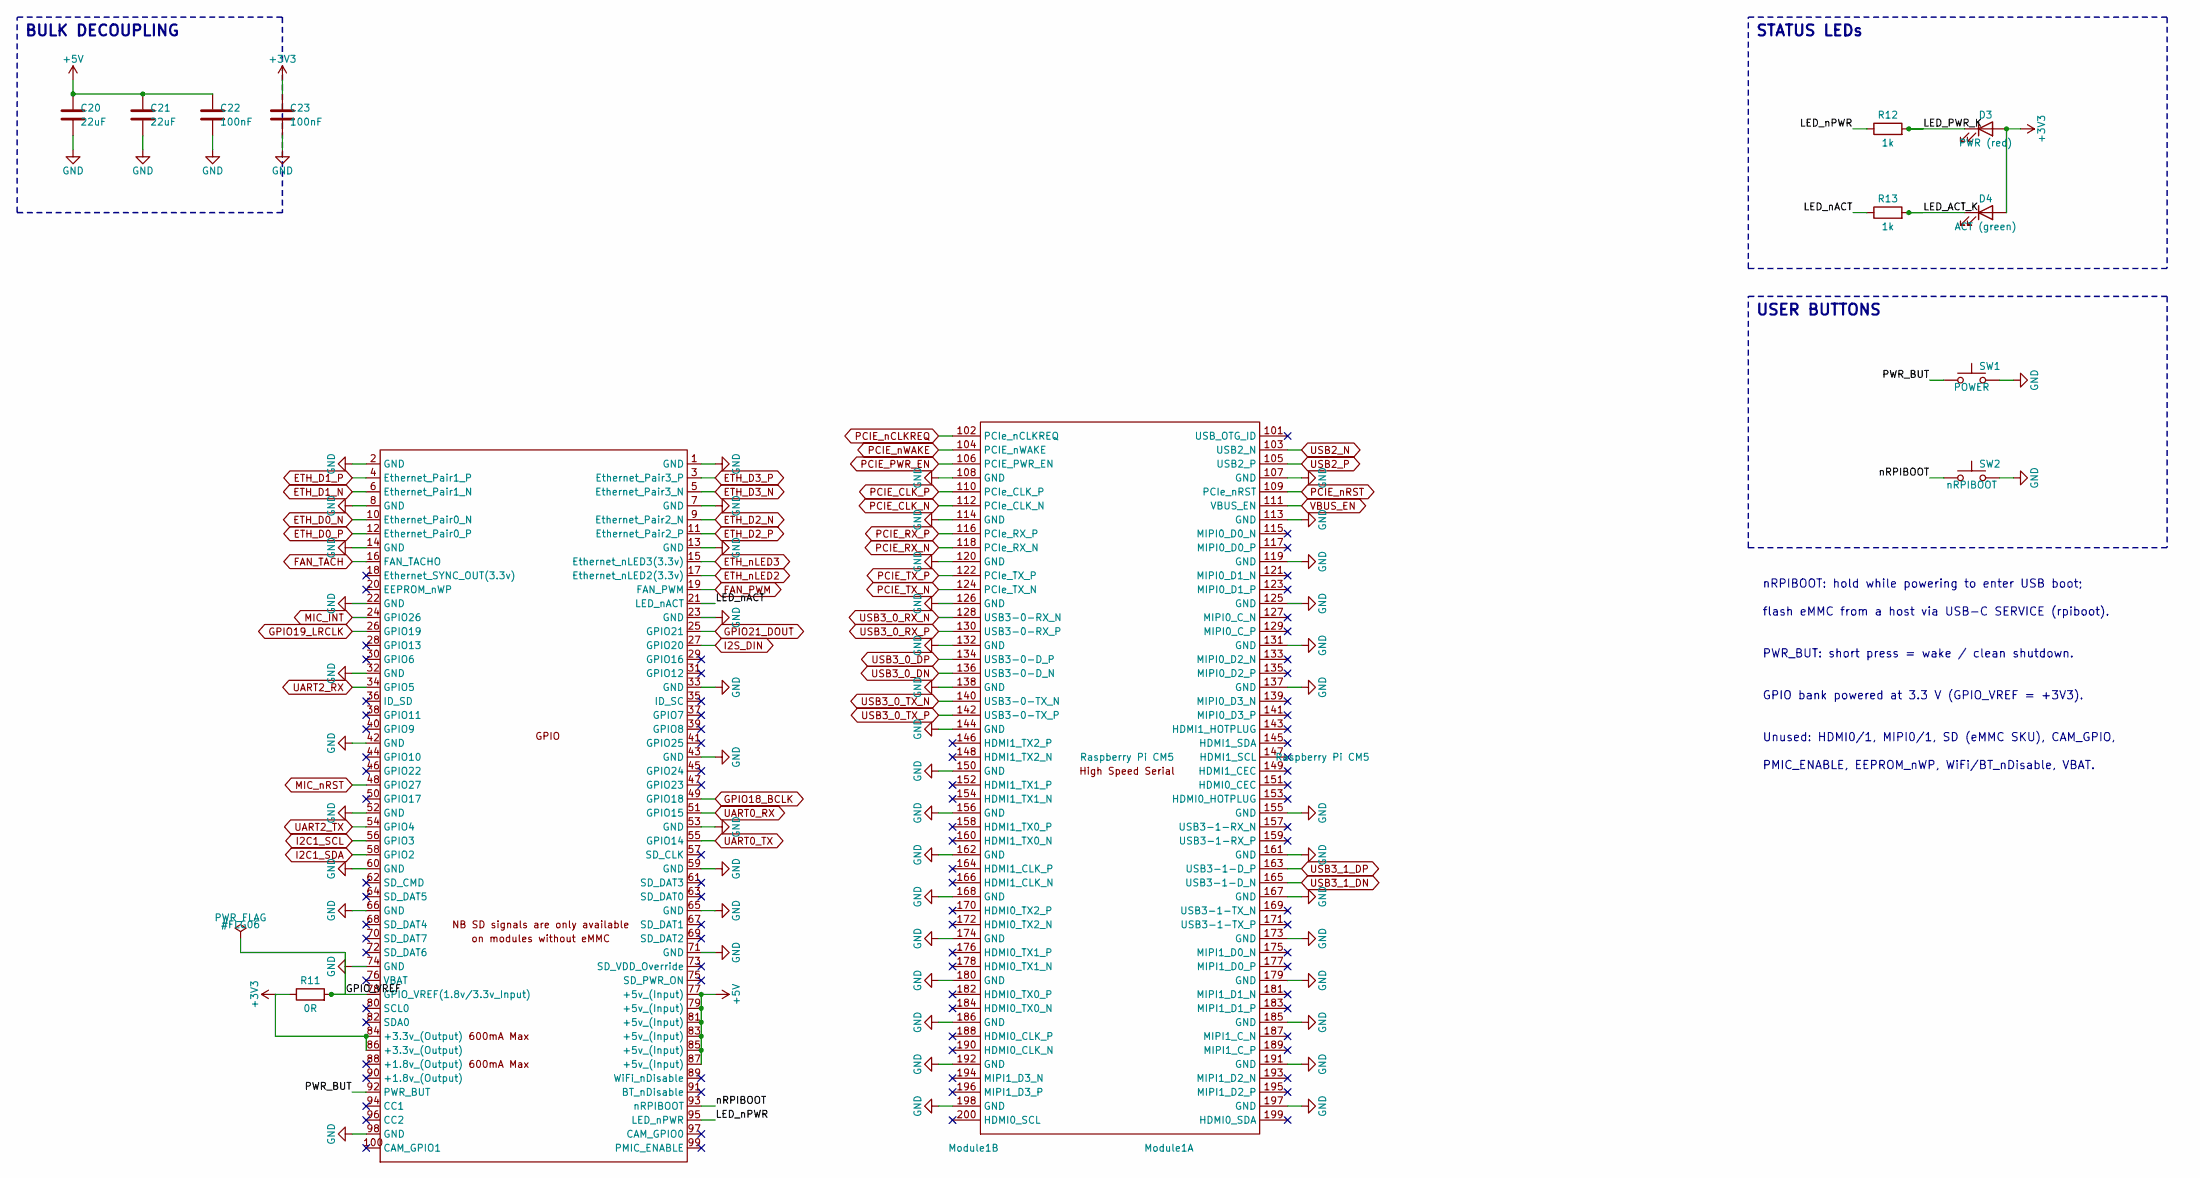
[picture p23: schematic compute.kicad_sch, Raspberry Pi Compute Module 5]

Parts:
C20, C21: 22uF; C_0805_2012Metric; Voltage 10V; LCSC C45783
C22, C23: 100nF; C_0402_1005Metric; Voltage 16V; LCSC C1525
D3: PWR (red); LED_0603_1608Metric; LCSC C2286
D4: ACT (green); LED_0603_1608Metric; LCSC C72043
Module1: Raspberry Pi CM5; RPi_CM5_DF40; MPN Raspberry Pi CM5 + 2x Hirose DF40C-100D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; LCSC C597931 (x2)
R11: 0R; R_0402_1005Metric; Tolerance 1%; LCSC C17168
R12, R13: 1k; R_0402_1005Metric; Tolerance 1%; LCSC C11702
SW1: POWER; SW_SPST_B3U-1000P; MPN Omron B3U-1000P; LCSC C231329
SW2: nRPIBOOT; SW_SPST_B3U-1000P; MPN Omron B3U-1000P; LCSC C231329

Connections:
+3V3: C23.1, D3.2 (A), D4.2 (A), Module1.84 (+3.3v_(Output)), Module1.86 (+3.3v_(Output)), R11.1; also elsewhere on the board
+5V: C20.1, C21.1, C22.1, Module1.77 (+5v_(Input)), Module1.79 (+5v_(Input)), Module1.81 (+5v_(Input)), Module1.83 (+5v_(Input)), Module1.85 (+5v_(Input)), Module1.87 (+5v_(Input)); also elsewhere on the board
/Compute/GPIO_VREF: Module1.78 (GPIO_VREF(1.8v/3.3v_Input)), R11.2
/Compute/LED_ACT_K: D4.1 (K), R13.2
/Compute/LED_PWR_K: D3.1 (K), R12.2
/Compute/LED_nACT: Module1.21 (LED_nACT), R13.1
/Compute/LED_nPWR: Module1.95 (LED_nPWR), R12.1
/Compute/PWR_BUT: Module1.92 (PWR_BUT), SW1.1
/Compute/nRPIBOOT: Module1.93 (nRPIBOOT), SW2.1
ETH_D0_N: Module1.10 (Ethernet_Pair0_N); also elsewhere on the board
ETH_D0_P: Module1.12 (Ethernet_Pair0_P); also elsewhere on the board
ETH_D1_N: Module1.6 (Ethernet_Pair1_N); also elsewhere on the board
ETH_D1_P: Module1.4 (Ethernet_Pair1_P); also elsewhere on the board
ETH_D2_N: Module1.9 (Ethernet_Pair2_N); also elsewhere on the board
ETH_D2_P: Module1.11 (Ethernet_Pair2_P); also elsewhere on the board
ETH_D3_N: Module1.5 (Ethernet_Pair3_N); also elsewhere on the board
ETH_D3_P: Module1.3 (Ethernet_Pair3_P); also elsewhere on the board
ETH_nLED2: Module1.17 (Ethernet_nLED2(3.3v)); also elsewhere on the board
ETH_nLED3: Module1.15 (Ethernet_nLED3(3.3v)); also elsewhere on the board
FAN_PWM: Module1.19 (FAN_PWM); also elsewhere on the board
FAN_TACH: Module1.16 (FAN_TACHO); also elsewhere on the board
GND: C20.2, C21.2, C22.2, C23.2, Module1.1 (GND), Module1.2 (GND), Module1.7 (GND), Module1.8 (GND), Module1.13 (GND), Module1.14 (GND), Module1.22 (GND), Module1.23 (GND), Module1.32 (GND), Module1.33 (GND), Module1.42 (GND), Module1.43 (GND), Module1.52 (GND), Module1.53 (GND), Module1.59 (GND), Module1.60 (GND), Module1.65 (GND), Module1.66 (GND), Module1.71 (GND), Module1.74 (GND), Module1.98 (GND), Module1.107 (GND), Module1.108 (GND), Module1.113 (GND), Module1.114 (GND), Module1.119 (GND), Module1.120 (GND), Module1.125 (GND), Module1.126 (GND), Module1.131 (GND), Module1.132 (GND), Module1.137 (GND), Module1.138 (GND), Module1.144 (GND), Module1.150 (GND), Module1.155 (GND), Module1.156 (GND), Module1.161 (GND), Module1.162 (GND), Module1.167 (GND), Module1.168 (GND), Module1.173 (GND), Module1.174 (GND), Module1.179 (GND), Module1.180 (GND), Module1.185 (GND), Module1.186 (GND), Module1.191 (GND), Module1.192 (GND), Module1.197 (GND), Module1.198 (GND), SW1.2, SW2.2; also elsewhere on the board
GPIO18_BCLK: Module1.49 (GPIO18); also elsewhere on the board
GPIO19_LRCLK: Module1.26 (GPIO19); also elsewhere on the board
GPIO21_DOUT: Module1.25 (GPIO21); also elsewhere on the board
I2C1_SCL: Module1.56 (GPIO3); also elsewhere on the board
I2C1_SDA: Module1.58 (GPIO2); also elsewhere on the board
I2S_DIN: Module1.27 (GPIO20); also elsewhere on the board
MIC_INT: Module1.24 (GPIO26); also elsewhere on the board
MIC_nRST: Module1.48 (GPIO27); also elsewhere on the board
PCIE_CLK_N: Module1.112 (PCIe_CLK_N); also elsewhere on the board
PCIE_CLK_P: Module1.110 (PCIe_CLK_P); also elsewhere on the board
PCIE_PWR_EN: Module1.106 (PCIE_PWR_EN); also elsewhere on the board
PCIE_RX_N: Module1.118 (PCIe_RX_N); also elsewhere on the board
PCIE_RX_P: Module1.116 (PCIe_RX_P); also elsewhere on the board
PCIE_TX_N: Module1.124 (PCIe_TX_N); also elsewhere on the board
PCIE_TX_P: Module1.122 (PCIe_TX_P); also elsewhere on the board
PCIE_nCLKREQ: Module1.102 (PCIe_nCLKREQ); also elsewhere on the board
PCIE_nRST: Module1.109 (PCIe_nRST); also elsewhere on the board
PCIE_nWAKE: Module1.104 (PCIE_nWAKE); also elsewhere on the board
UART0_RX: Module1.51 (GPIO15); also elsewhere on the board
UART0_TX: Module1.55 (GPIO14); also elsewhere on the board
UART2_RX: Module1.34 (GPIO5); also elsewhere on the board
UART2_TX: Module1.54 (GPIO4); also elsewhere on the board
USB2_N: Module1.103 (USB2_N); also elsewhere on the board
USB2_P: Module1.105 (USB2_P); also elsewhere on the board
USB3_0_DN: Module1.136 (USB3-0-D_N); also elsewhere on the board
USB3_0_DP: Module1.134 (USB3-0-D_P); also elsewhere on the board
USB3_0_RX_N: Module1.128 (USB3-0-RX_N); also elsewhere on the board
USB3_0_RX_P: Module1.130 (USB3-0-RX_P); also elsewhere on the board
USB3_0_TX_N: Module1.140 (USB3-0-TX_N); also elsewhere on the board
USB3_0_TX_P: Module1.142 (USB3-0-TX_P); also elsewhere on the board
USB3_1_DN: Module1.165 (USB3-1-D_N); also elsewhere on the board
USB3_1_DP: Module1.163 (USB3-1-D_P); also elsewhere on the board
VBUS_EN: Module1.111 (VBUS_EN); also elsewhere on the board

Notes on the sheet:
BULK DECOUPLING
STATUS LEDs
USER BUTTONS
nRPIBOOT: hold while powering to enter USB boot;
flash eMMC from a host via USB-C SERVICE (rpiboot).
PWR_BUT: short press = wake / clean shutdown.
GPIO bank powered at 3.3 V (GPIO_VREF = +3V3).
Unused: HDMI0/1, MIPI0/1, SD (eMMC SKU), CAM_GPIO,
PMIC_ENABLE, EEPROM_nWP, WiFi/BT_nDisable, VBAT.

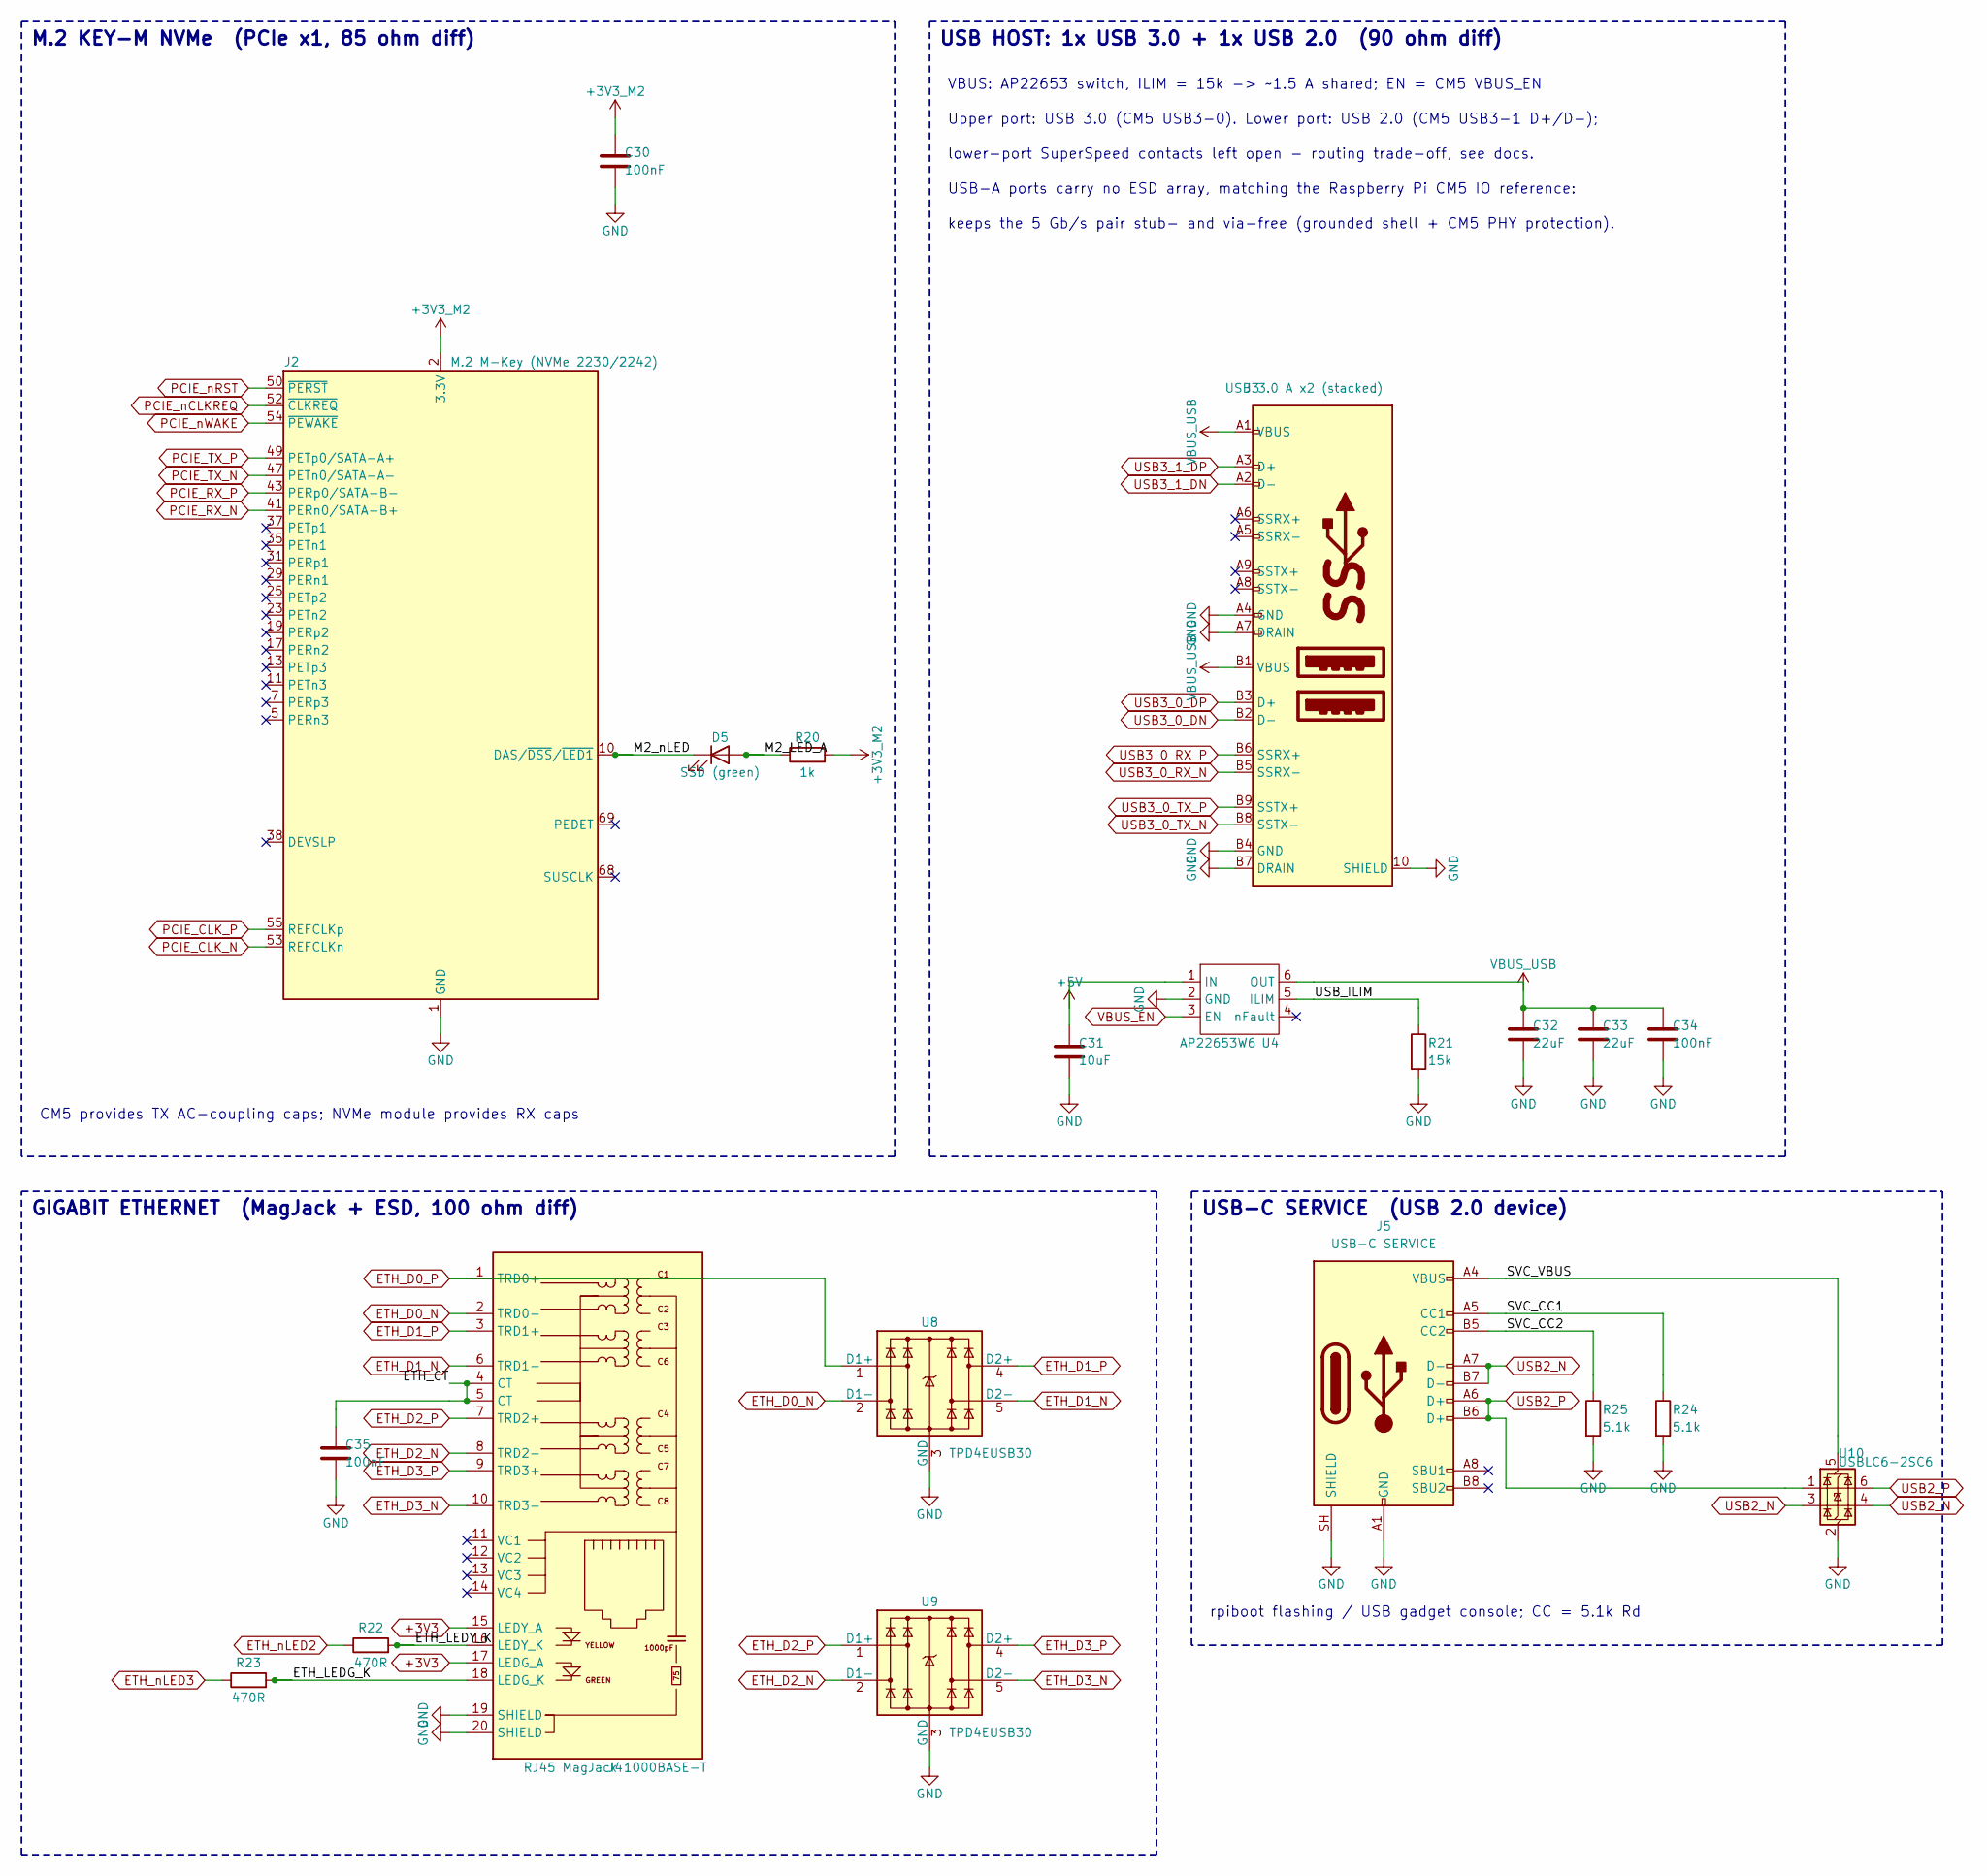
[picture p24: schematic highspeed.kicad_sch, High-Speed IO: PCIe NVMe, USB 3.0, GbE, USB-C Service]

Parts:
C30, C34, C35: 100nF; C_0402_1005Metric; Voltage 16V; LCSC C1525
C31: 10uF; C_0805_2012Metric; Voltage 10V; LCSC C15850
C32, C33: 22uF; C_0805_2012Metric; Voltage 10V; LCSC C45783
D5: SSD (green); LED_0603_1608Metric; LCSC C72043
J2: M.2 M-Key (NVMe 2230/2242); M.2_M_Key_2242; MPN MTCONN MTSSD03-67MSW337 (H=3.2 mm)
J3: USB 3.0 A x2 (stacked); MTCONN_UBAF30-D2011; MPN MTCONN UBAF30-D2011
J4: RJ45 MagJack 1000BASE-T; TRJG0926HENL; MPN Trxcom TRJG0926HENL
J5: USB-C SERVICE; USB_C_Receptacle_GCT_USB4105-xx-A_16P_TopMnt_Horizontal; MPN GCT USB4105-GF-A; LCSC C3020560
R20: 1k; R_0402_1005Metric; Tolerance 1%; LCSC C11702
R21: 15k; R_0402_1005Metric; Tolerance 1%; LCSC C25756
R22, R23: 470R; R_0402_1005Metric; Tolerance 1%; LCSC C25117
R24, R25: 5.1k; R_0402_1005Metric; Tolerance 1%; LCSC C25905
U4: AP22653W6; SOT-23-6; MPN Diodes AP22653W6-7
U8, U9: TPD4EUSB30; USON-10_2.5x1.0mm_P0.5mm; MPN TI TPD4EUSB30DQAR
U10: USBLC6-2SC6; SOT-23-6; MPN ST USBLC6-2SC6; LCSC C7519

Connections:
+3V3: J4.15 (LEDY_A), J4.17 (LEDG_A); also elsewhere on the board
+3V3_M2: C30.1, J2.2 (3.3V), J2.4 (3.3V), J2.12 (3.3V), J2.14 (3.3V), J2.16 (3.3V), J2.18 (3.3V), J2.70 (3.3V), J2.72 (3.3V), J2.74 (3.3V), R20.2; also elsewhere on the board
+5V: C31.1, U4.1 (IN); also elsewhere on the board
/HighSpeed/ETH_CT: C35.1, J4.4 (CT), J4.5 (CT)
/HighSpeed/ETH_LEDG_K: J4.18 (LEDG_K), R23.2
/HighSpeed/ETH_LEDY_K: J4.16 (LEDY_K), R22.2
/HighSpeed/M2_LED_A: D5.2 (A), R20.1
/HighSpeed/M2_nLED: D5.1 (K), J2.10 (DAS/~DSS/~LED1)
/HighSpeed/SVC_CC1: J5.A5 (CC1), R24.1
/HighSpeed/SVC_CC2: J5.B5 (CC2), R25.1
/HighSpeed/SVC_VBUS: J5.A4 (VBUS), J5.A9 (VBUS), J5.B4 (VBUS), J5.B9 (VBUS), U10.5 (VBUS)
/HighSpeed/USB_ILIM: R21.1, U4.5 (ILIM)
ETH_D0_N: J4.2 (TRD0-), U8.2 (D1-), U8.9; also elsewhere on the board
ETH_D0_P: J4.1 (TRD0+), U8.1 (D1+), U8.10; also elsewhere on the board
ETH_D1_N: J4.6 (TRD1-), U8.5 (D2-), U8.6; also elsewhere on the board
ETH_D1_P: J4.3 (TRD1+), U8.4 (D2+), U8.7; also elsewhere on the board
ETH_D2_N: J4.8 (TRD2-), U9.2 (D1-), U9.9; also elsewhere on the board
ETH_D2_P: J4.7 (TRD2+), U9.1 (D1+), U9.10; also elsewhere on the board
ETH_D3_N: J4.10 (TRD3-), U9.5 (D2-), U9.6; also elsewhere on the board
ETH_D3_P: J4.9 (TRD3+), U9.4 (D2+), U9.7; also elsewhere on the board
ETH_nLED2: R22.1; also elsewhere on the board
ETH_nLED3: R23.1; also elsewhere on the board
GND: C30.2, C31.2, C32.2, C33.2, C34.2, C35.2, J2.1 (GND), J2.3 (GND), J2.9 (GND), J2.15 (GND), J2.21 (GND), J2.27 (GND), J2.33 (GND), J2.39 (GND), J2.45 (GND), J2.51 (GND), J2.57 (GND), J2.71 (GND), J2.73 (GND), J2.75 (GND), J3.10 (SHIELD), J3.A4 (GND), J3.A7 (DRAIN), J3.B4 (GND), J3.B7 (DRAIN), J4.19 (SHIELD), J4.20 (SHIELD), J5.A1 (GND), J5.A12 (GND), J5.B1 (GND), J5.B12 (GND), J5.SH (SHIELD), R21.2, R24.2, R25.2, U4.2 (GND), U8.3 (GND), U8.8 (GND), U9.3 (GND), U9.8 (GND), U10.2 (GND); also elsewhere on the board
PCIE_CLK_N: J2.53 (REFCLKn); also elsewhere on the board
PCIE_CLK_P: J2.55 (REFCLKp); also elsewhere on the board
PCIE_RX_N: J2.41 (PERn0/SATA-B+); also elsewhere on the board
PCIE_RX_P: J2.43 (PERp0/SATA-B-); also elsewhere on the board
PCIE_TX_N: J2.47 (PETn0/SATA-A-); also elsewhere on the board
PCIE_TX_P: J2.49 (PETp0/SATA-A+); also elsewhere on the board
PCIE_nCLKREQ: J2.52 (~CLKREQ); also elsewhere on the board
PCIE_nRST: J2.50 (~PERST); also elsewhere on the board
PCIE_nWAKE: J2.54 (~PEWAKE); also elsewhere on the board
USB2_N: J5.A7 (D-), J5.B7 (D-), U10.3 (I/O2), U10.4 (I/O2); also elsewhere on the board
USB2_P: J5.A6 (D+), J5.B6 (D+), U10.1 (I/O1), U10.6 (I/O1); also elsewhere on the board
USB3_0_DN: J3.B2 (D-); also elsewhere on the board
USB3_0_DP: J3.B3 (D+); also elsewhere on the board
USB3_0_RX_N: J3.B5 (SSRX-); also elsewhere on the board
USB3_0_RX_P: J3.B6 (SSRX+); also elsewhere on the board
USB3_0_TX_N: J3.B8 (SSTX-); also elsewhere on the board
USB3_0_TX_P: J3.B9 (SSTX+); also elsewhere on the board
USB3_1_DN: J3.A2 (D-); also elsewhere on the board
USB3_1_DP: J3.A3 (D+); also elsewhere on the board
VBUS_EN: U4.3 (EN); also elsewhere on the board
VBUS_USB: C32.1, C33.1, C34.1, J3.A1 (VBUS), J3.B1 (VBUS), U4.6 (OUT)

Notes on the sheet:
M.2 KEY-M NVMe (PCIe x1, 85 ohm diff)
USB HOST: 1x USB 3.0 + 1x USB 2.0 (90 ohm diff)
GIGABIT ETHERNET (MagJack + ESD, 100 ohm diff)
USB-C SERVICE (USB 2.0 device)
VBUS: AP22653 switch, ILIM = 15k -> ~1.5 A shared; EN = CM5 VBUS_EN
CM5 provides TX AC-coupling caps; NVMe module provides RX caps
rpiboot flashing / USB gadget console; CC = 5.1k Rd
USB-A ports carry no ESD array, matching the Raspberry Pi CM5 IO reference:
keeps the 5 Gb/s pair stub- and via-free (grounded shell + CM5 PHY protection).
Upper port: USB 3.0 (CM5 USB3-0). Lower port: USB 2.0 (CM5 USB3-1 D+/D-);
lower-port SuperSpeed contacts left open - routing trade-off, see docs.

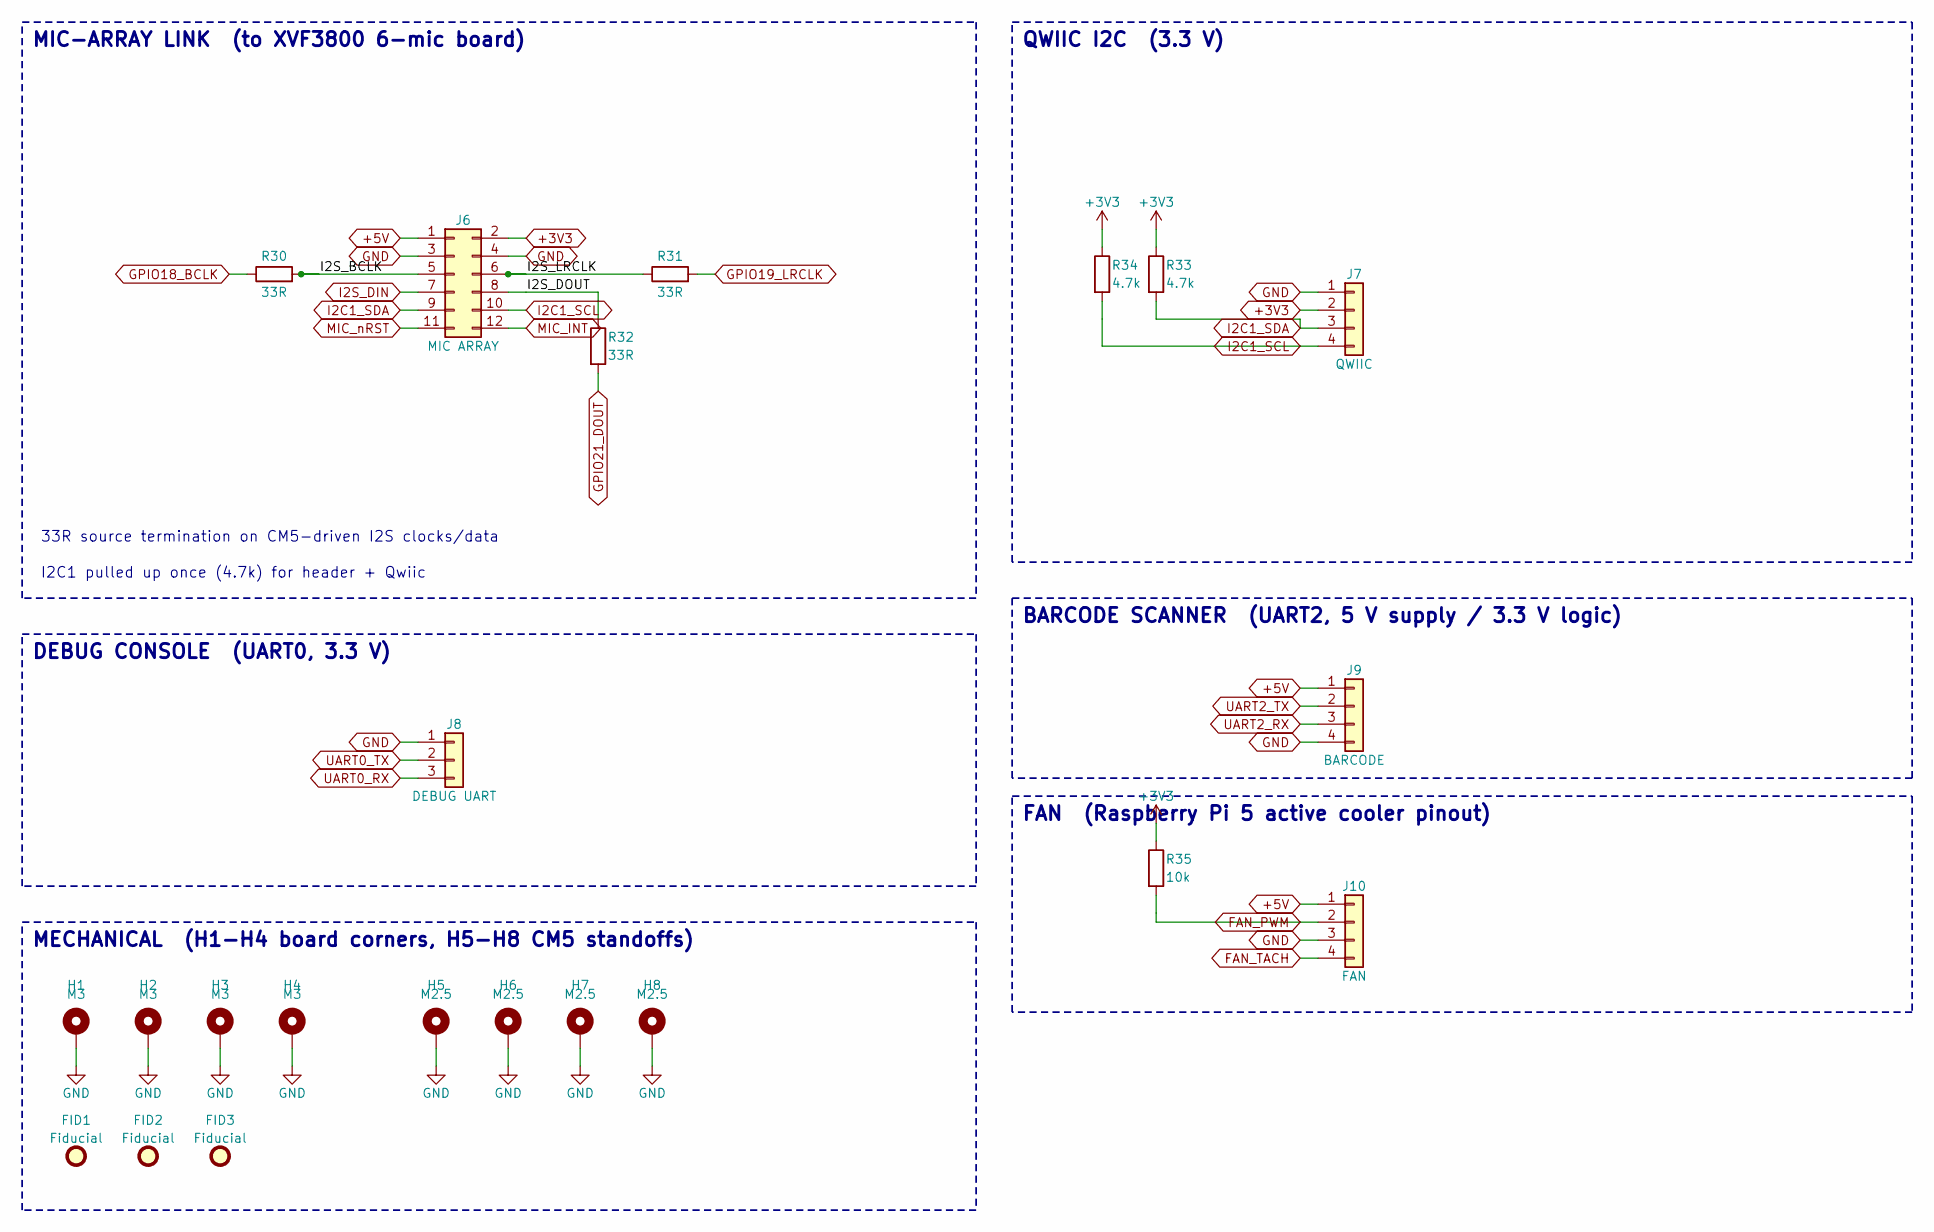
[picture p25: schematic periph_io.kicad_sch, Peripheral IO: Mic-Array I2S, UARTs, I2C, Fan]

Parts:
FID1, FID2, FID3: Fiducial; Fiducial_1mm_Mask2mm
H1, H2, H3, H4: M3; MountingHole_3.2mm_M3_Pad_Via
H5, H6, H7, H8: M2.5; MountingHole_2.7mm_M2.5_Pad_Via
J6: MIC ARRAY; IDC-Header_2x06_P2.54mm_Vertical; MPN 2x6 2.54 mm shrouded box header
J7: QWIIC; JST_SH_SM04B-SRSS-TB_1x04-1MP_P1.00mm_Horizontal; MPN JST SM04B-SRSS-TB; LCSC C160404
J8: DEBUG UART; PinHeader_1x03_P2.54mm_Vertical
J9: BARCODE; JST_SH_SM04B-SRSS-TB_1x04-1MP_P1.00mm_Horizontal; MPN JST SM04B-SRSS-TB; LCSC C160404
J10: FAN; JST_SH_SM04B-SRSS-TB_1x04-1MP_P1.00mm_Horizontal; MPN JST SM04B-SRSS-TB; LCSC C160404
R30, R31, R32: 33R; R_0402_1005Metric; Tolerance 1%; LCSC C25105
R33, R34: 4.7k; R_0402_1005Metric; Tolerance 1%; LCSC C25900
R35: 10k; R_0402_1005Metric; Tolerance 1%; LCSC C25744

Connections:
+3V3: J6.2, J7.2, R33.1, R34.1, R35.1; also elsewhere on the board
+5V: J6.1, J9.1, J10.1; also elsewhere on the board
/PeriphIO/I2S_BCLK: J6.5, R30.2
/PeriphIO/I2S_DOUT: J6.8, R32.1
/PeriphIO/I2S_LRCLK: J6.6, R31.1
FAN_PWM: J10.2, R35.2; also elsewhere on the board
FAN_TACH: J10.4; also elsewhere on the board
GND: H1.1, H2.1, H3.1, H4.1, H5.1, H6.1, H7.1, H8.1, J6.3, J6.4, J7.1, J8.1, J9.4, J10.3; also elsewhere on the board
GPIO18_BCLK: R30.1; also elsewhere on the board
GPIO19_LRCLK: R31.2; also elsewhere on the board
GPIO21_DOUT: R32.2; also elsewhere on the board
I2C1_SCL: J6.10, J7.4, R34.2; also elsewhere on the board
I2C1_SDA: J6.9, J7.3, R33.2; also elsewhere on the board
I2S_DIN: J6.7; also elsewhere on the board
MIC_INT: J6.12; also elsewhere on the board
MIC_nRST: J6.11; also elsewhere on the board
UART0_RX: J8.3; also elsewhere on the board
UART0_TX: J8.2; also elsewhere on the board
UART2_RX: J9.3; also elsewhere on the board
UART2_TX: J9.2; also elsewhere on the board

Notes on the sheet:
MIC-ARRAY LINK (to XVF3800 6-mic board)
QWIIC I2C (3.3 V)
DEBUG CONSOLE (UART0, 3.3 V)
BARCODE SCANNER (UART2, 5 V supply / 3.3 V logic)
FAN (Raspberry Pi 5 active cooler pinout)
MECHANICAL (H1-H4 board corners, H5-H8 CM5 standoffs)
33R source termination on CM5-driven I2S clocks/data
I2C1 pulled up once (4.7k) for header + Qwiic
