xmyoot/rpi-cm5-edge-carrier/hardware/CM5_Edge_Carrier.kicad_pcb

## KiCad design hardware/CM5_Edge_Carrier.kicad_pcb (continued)

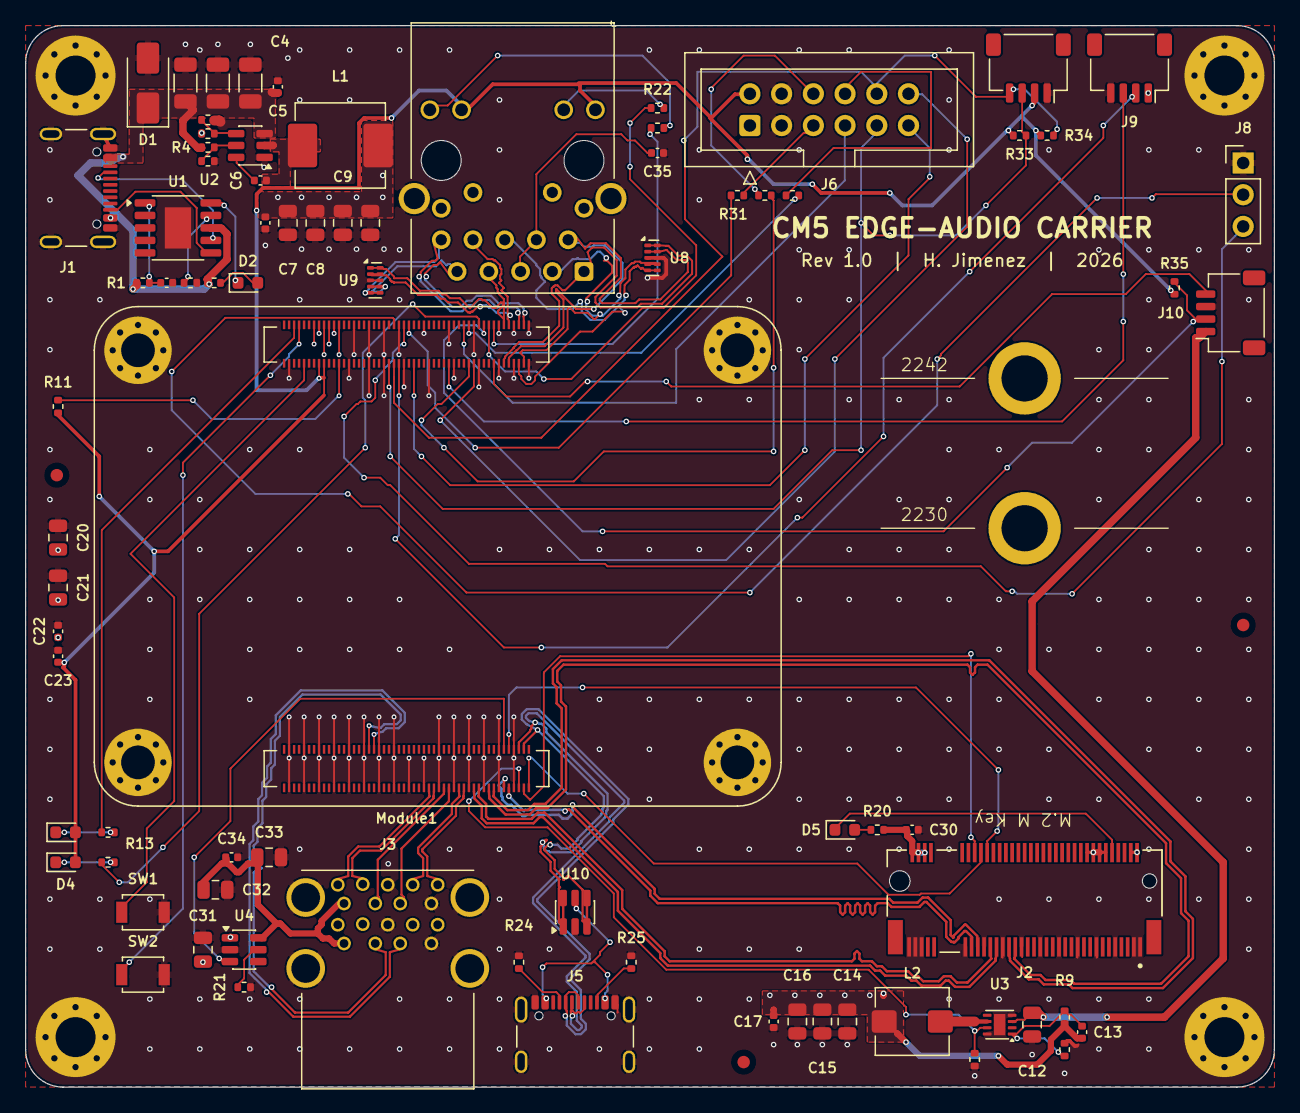
[picture p26: board CM5_Edge_Carrier.kicad_pcb from above]

Board: 4 copper layers, 100.0 x 85.0 mm, 90 parts (0 on the bottom side), 82 nets.
